gallicchio/earth-nmr-pcb/design_reviews/2026-11-03_Claude-Fable-5.1/back_12.png

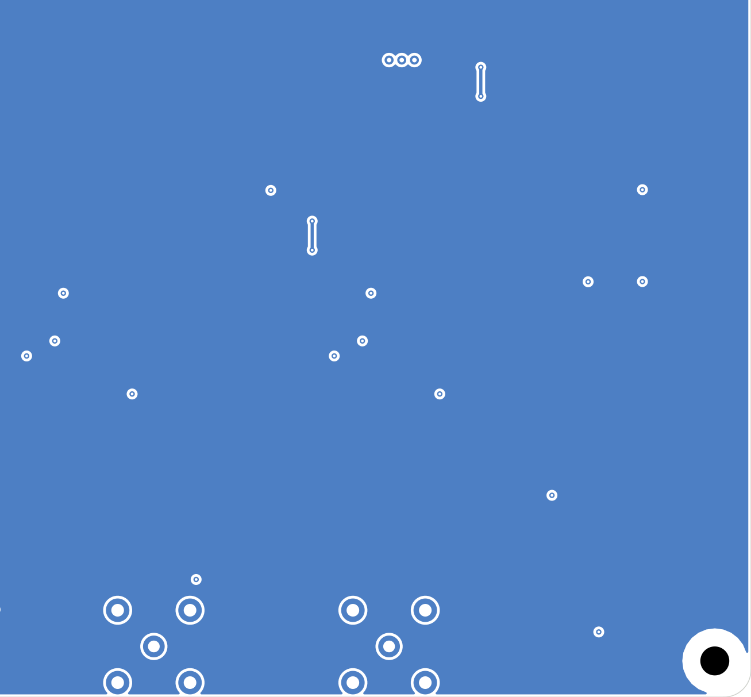
design_reviews/2026-11-03_Claude-Fable-5.1/back_12.png
