gallicchio/earth-nmr-pcb/design_reviews/2026-11-03_Claude-Fable-5.1/sch_relay_sync.png

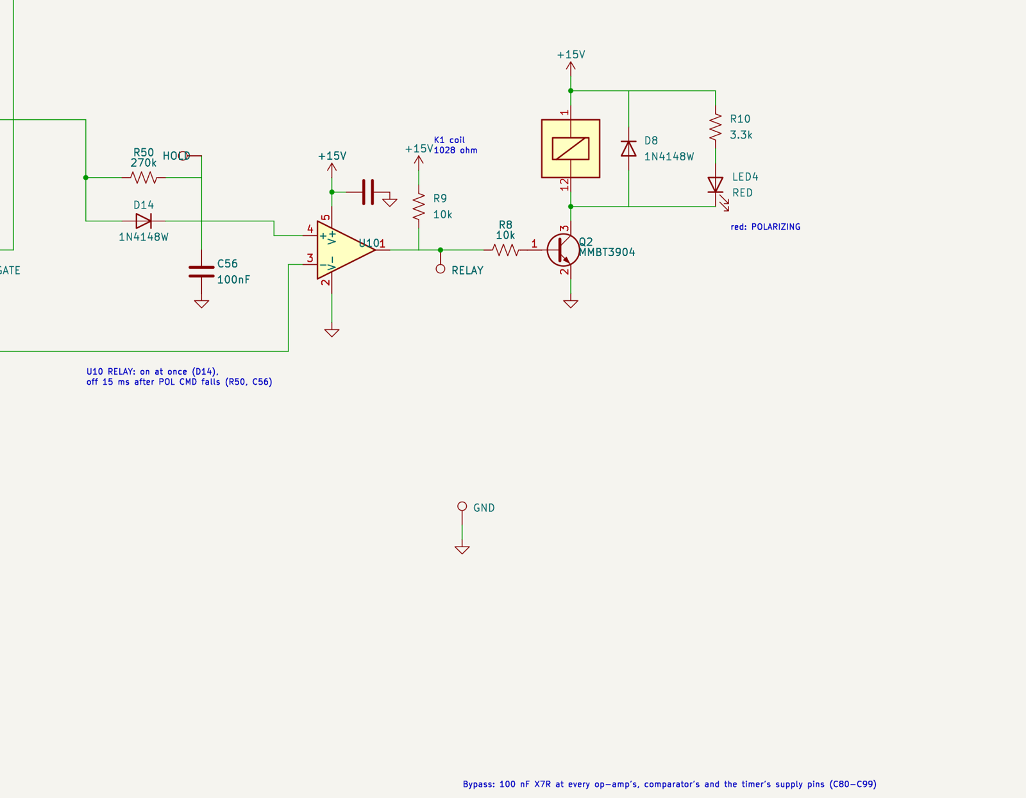
design_reviews/2026-11-03_Claude-Fable-5.1/sch_relay_sync.png
