gallicchio/earth-nmr-pcb/docs/images/earthnmr-bottom.png

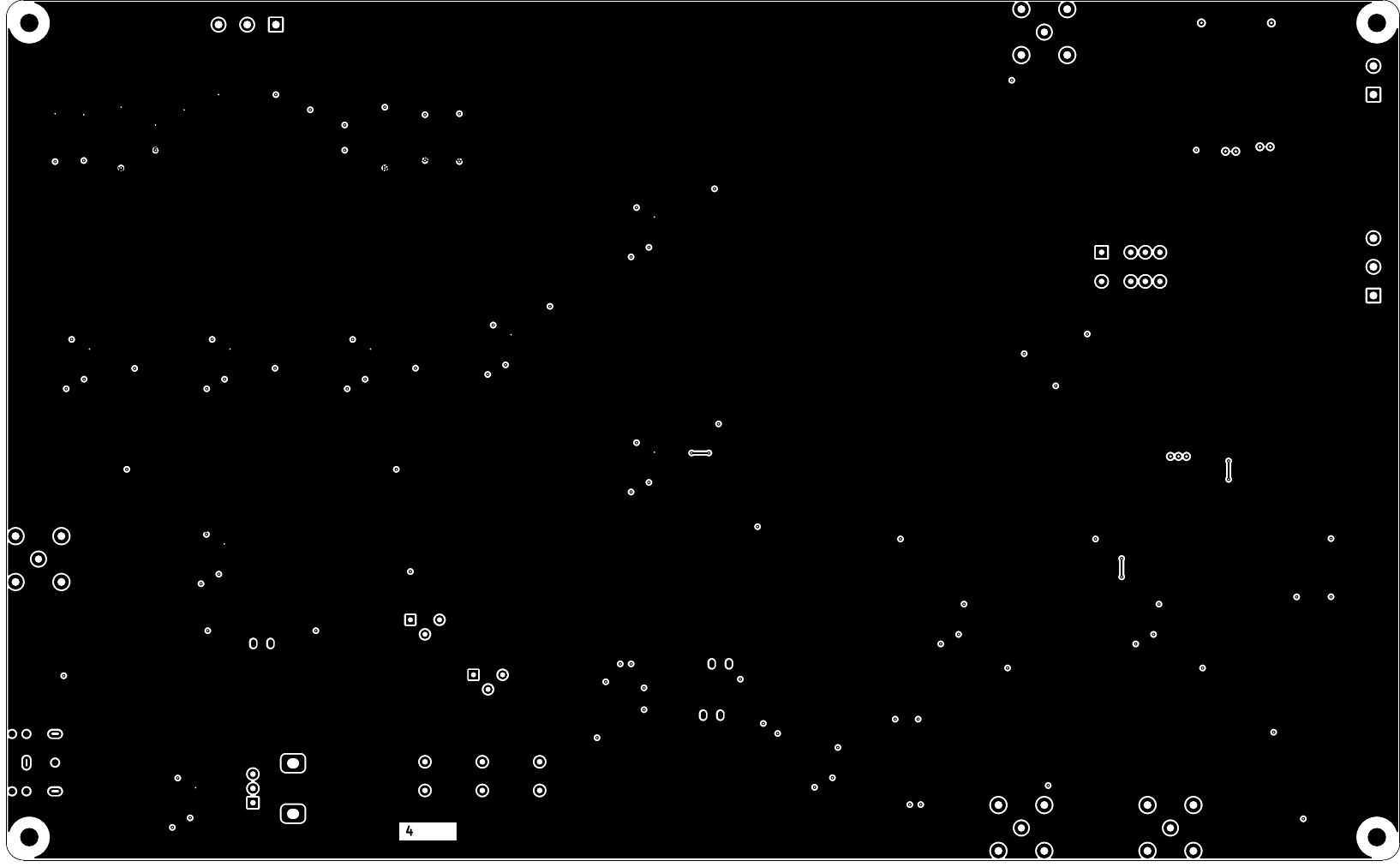
docs/images/earthnmr-bottom.png
