gallicchio/earth-nmr-pcb/docs/images/earthnmr-in1-ground.png

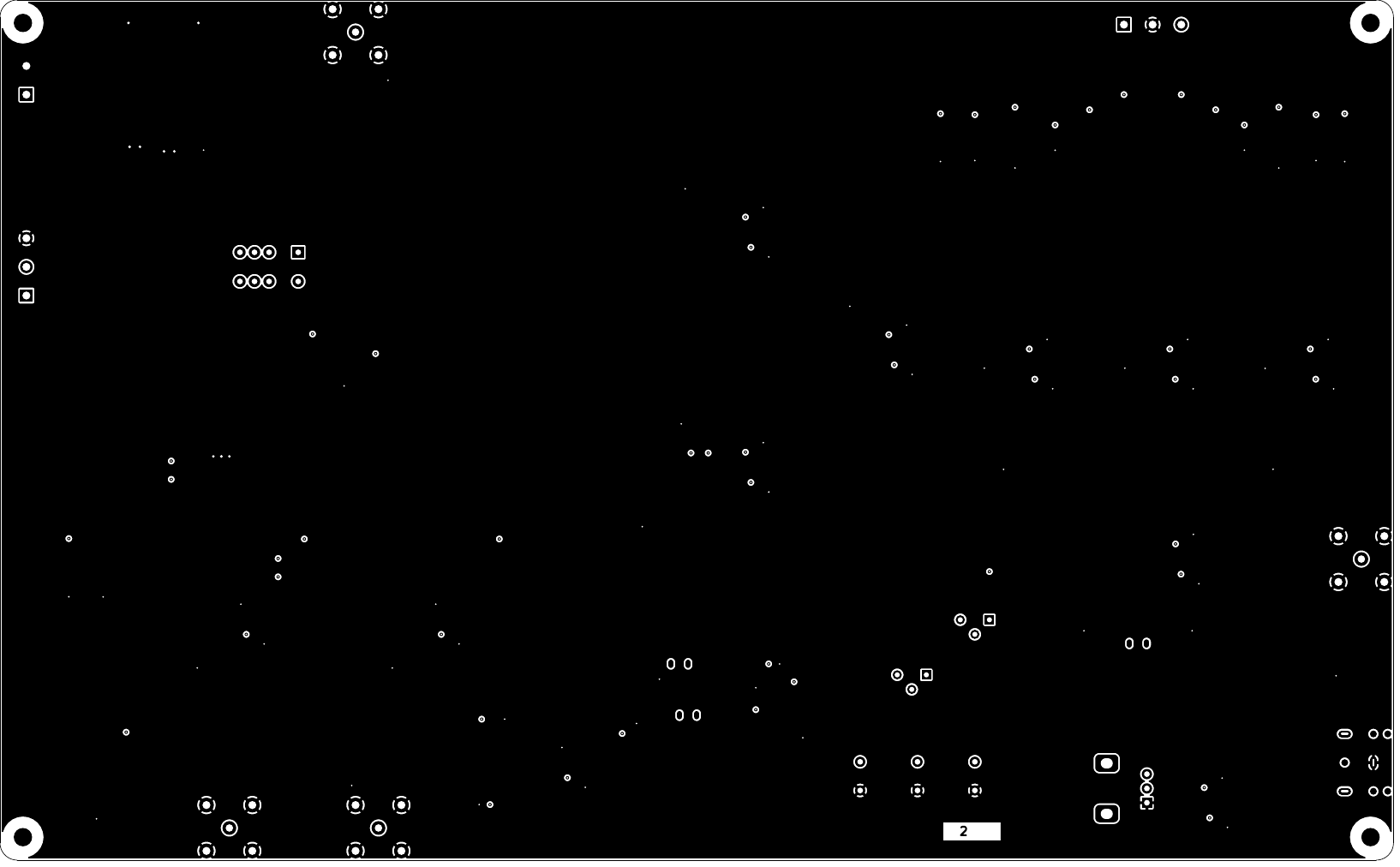
docs/images/earthnmr-in1-ground.png
