gallicchio/earth-nmr-pcb/docs/images/earthnmr-in2-plus15.png

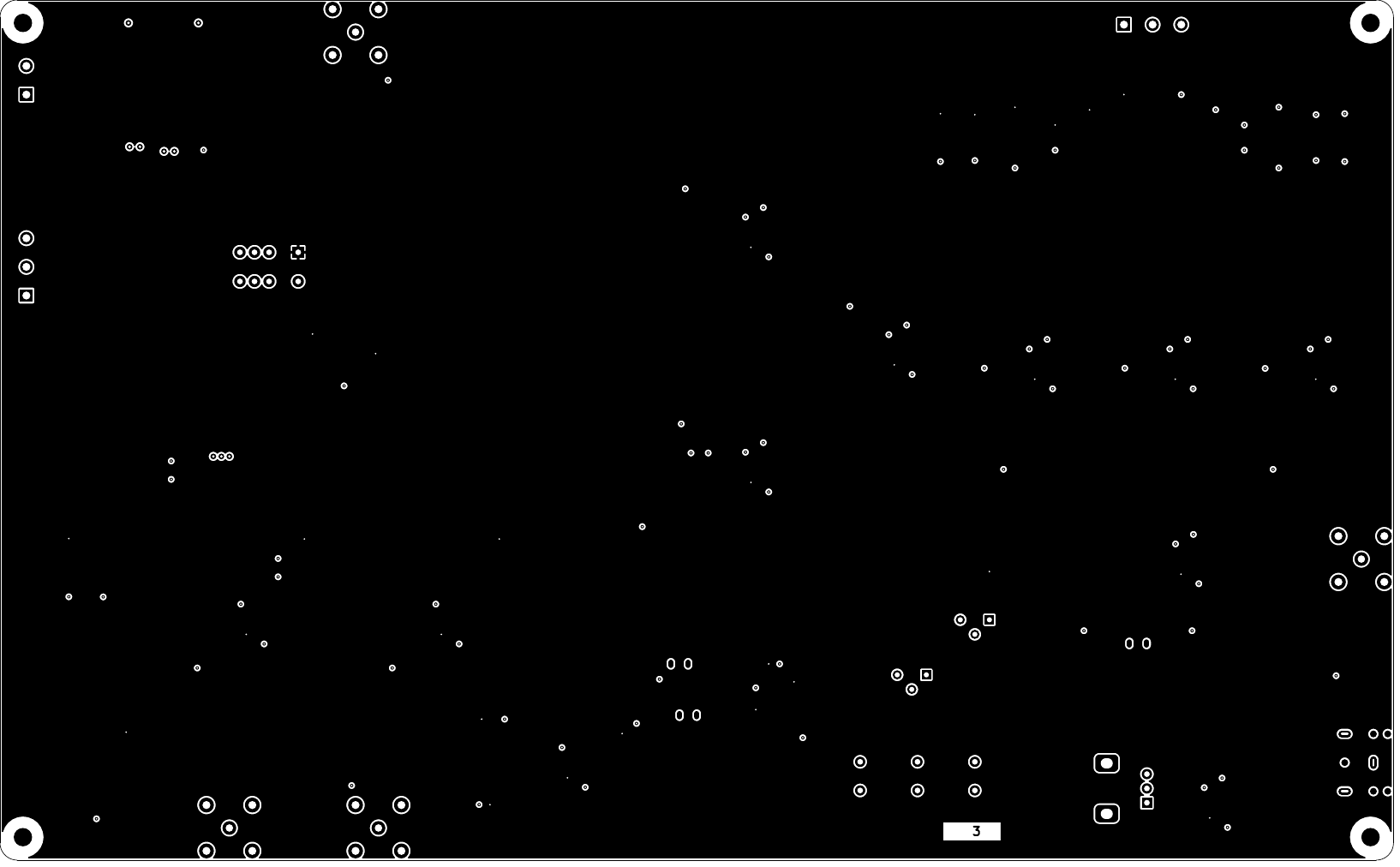
docs/images/earthnmr-in2-plus15.png
