gallicchio/earth-nmr-pcb/docs/images/earthnmr-render-bottom.png

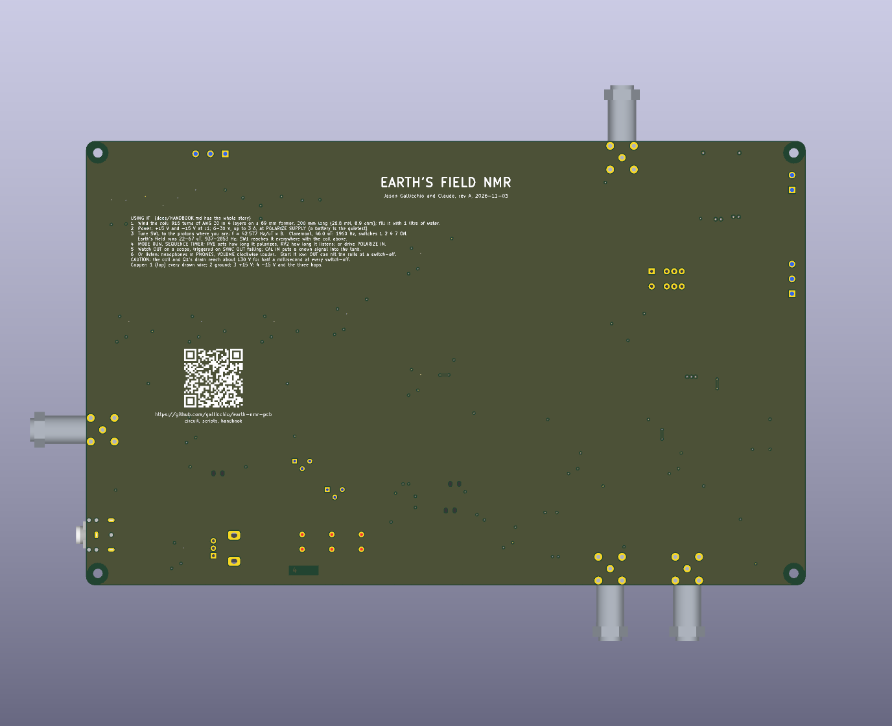
docs/images/earthnmr-render-bottom.png
