gallicchio/earth-nmr-pcb/docs/images/earthnmr-silk-bottom.png

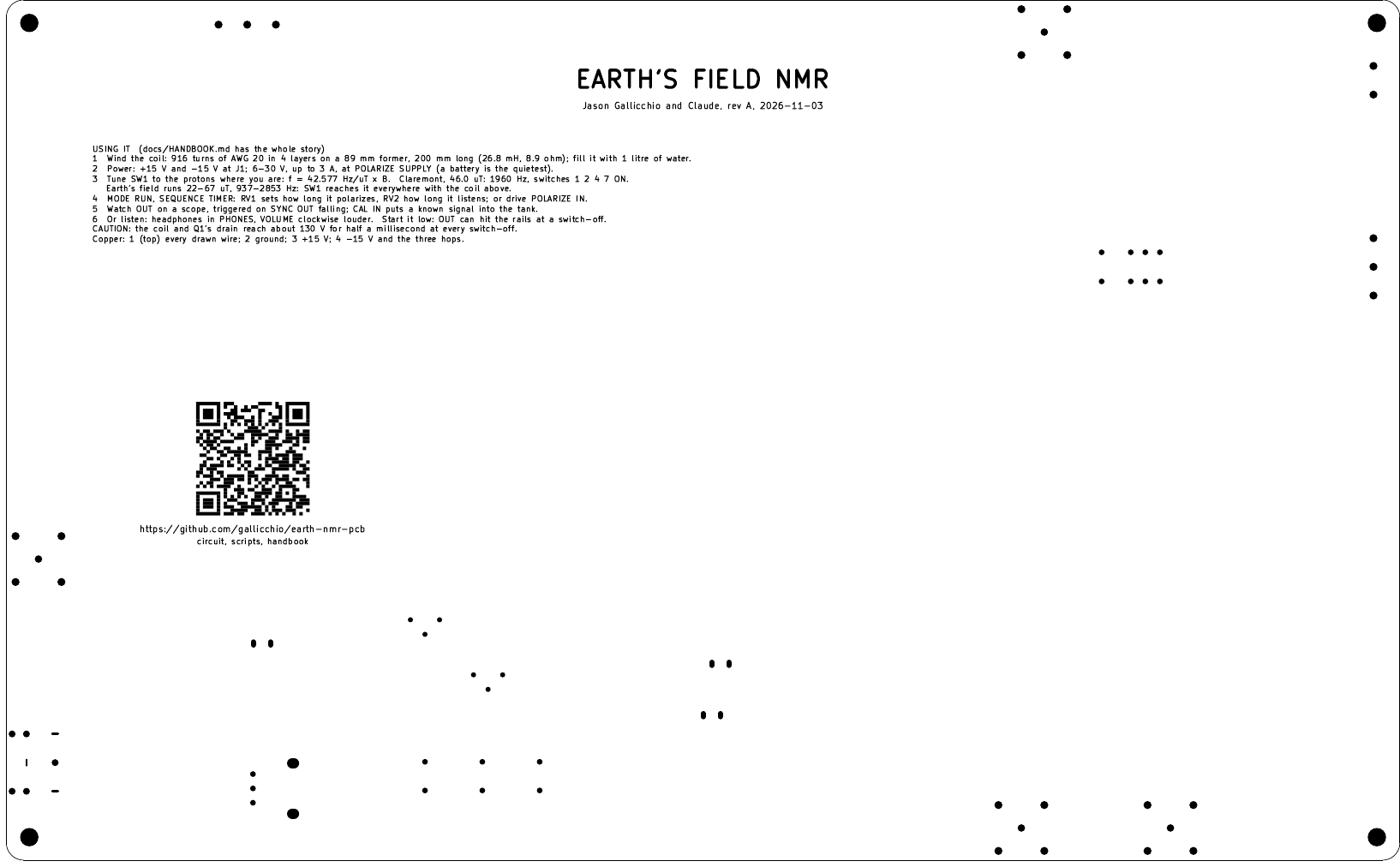
docs/images/earthnmr-silk-bottom.png
