gallicchio/earth-nmr-pcb/docs/images/earthnmr-silk-top.png

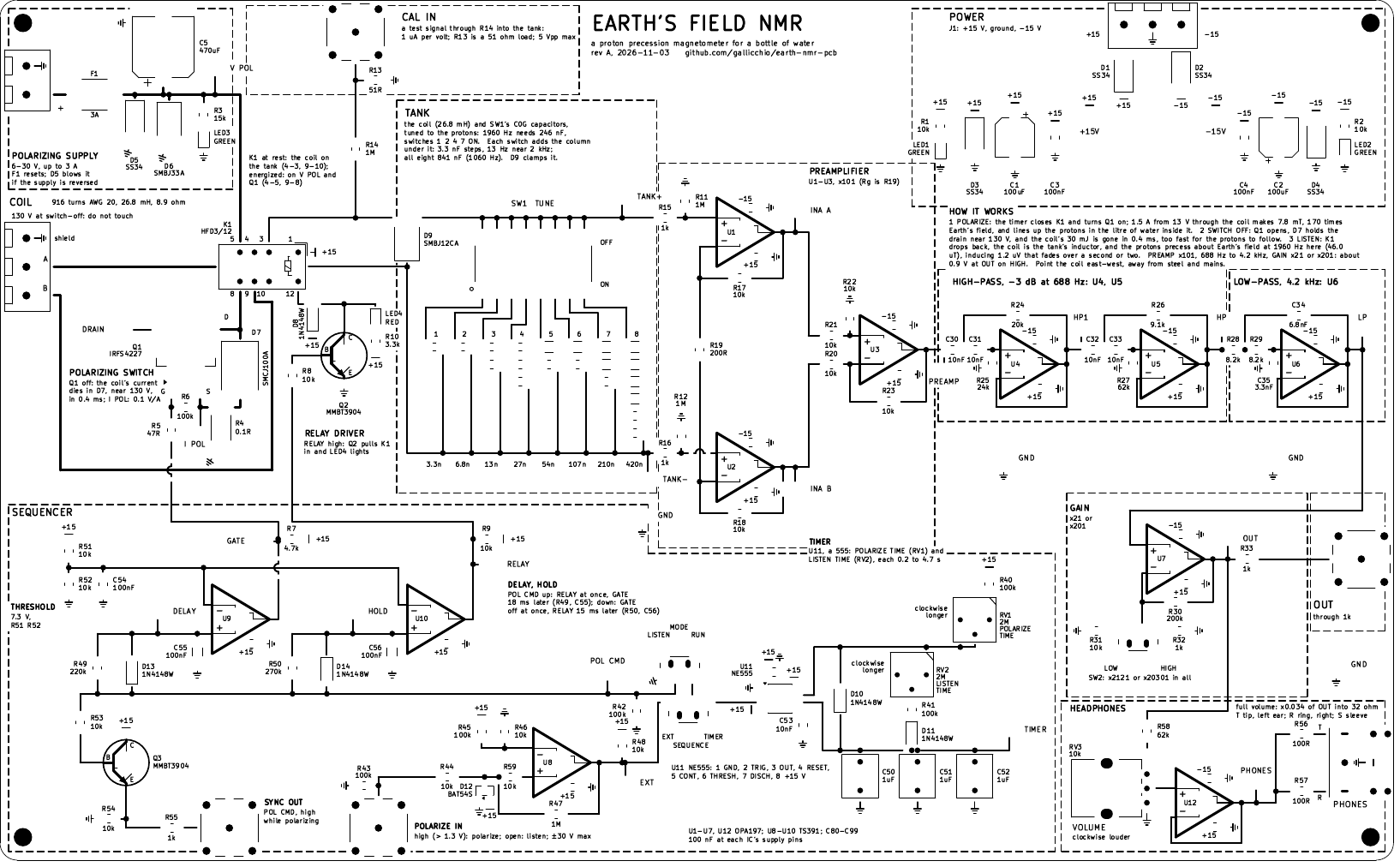
docs/images/earthnmr-silk-top.png
