gallicchio/earth-nmr-pcb/docs/images/sim_receiver.png

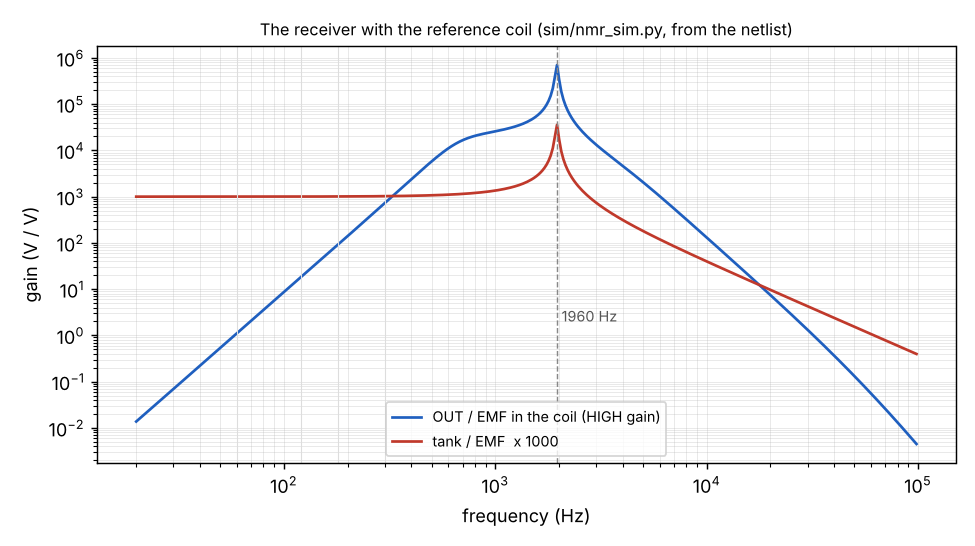
docs/images/sim_receiver.png
