gallicchio/earth-nmr-pcb/docs/images/sim_switch_off.png

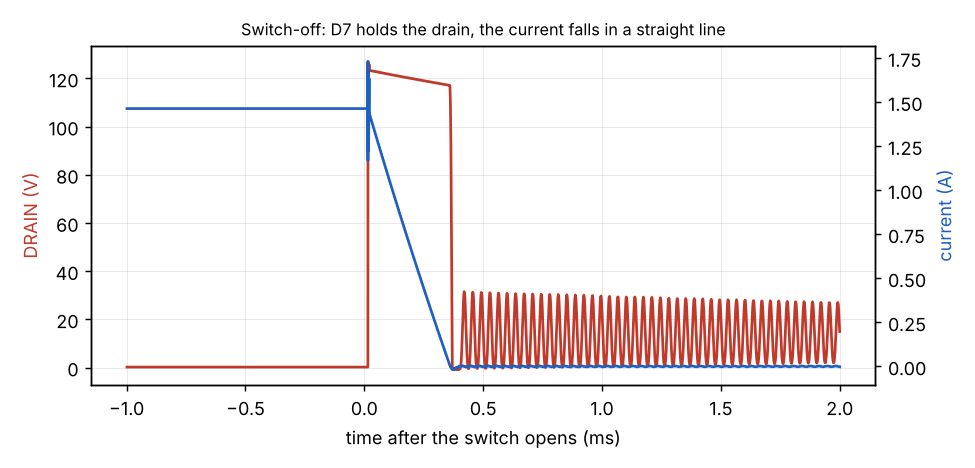
docs/images/sim_switch_off.png
