gallicchio/earth-nmr-pcb/out/earthnmr/earthnmr_bom_costed.csv

Comment | Designator | Footprint | LCSC Part # | MPN | Qty | Unit $ | Ext $ | JLC
470uF | C5 | CP_Elec_10x12.5 | C22469994 | EFVM050ADA471M10C0 | 1 | 0.1755 | 0.175 | extended
47nF | C17 | C_1206_3216Metric | C5451690 | C1206N473J050T | 1 | 0.1795 | 0.179 | extended
100uF | C1,C2 | CP_Elec_6.3x5.4 | C46550402 | JVJ25V100M6x5 | 2 | 0.0423 | 0.085 | extended
3.3nF | C10,C13,C35 | C_0805_2012Metric | C880847 | 0805N332J101CT | 3 | 0.0214 | 0.064 | extended
1uF | C50,C51,C52 | C_Film_P5.00mm_L7.2mm_W6.0mm | C333829 | MES105J2A-7-50R0 | 3 | 0.1387 | 0.416 | extended
6.8nF | C11,C16,C18,C20,C34 | C_0805_2012Metric | C326913 | CC0805JKNPO9BN682 | 5 | 0.0904 | 0.452 | extended
100nF | C19,C21,C22,C24,C25,C26,C27,C55,C56 | C_1206_3216Metric | C170182 | 1206N104J500CT | 9 | 0.1580 | 1.422 | extended
10nF | C12,C14,C15,C23,C28,C29,C30,C31,C32,C33,C53 | C_0805_2012Metric | C237168 | 0805N103J500CT | 11 | 0.0302 | 0.332 | extended
100nF | C3,C4,C54,C80,C81,C82,C83,C84,C85,C86,C87,C88,C89,C90,C91,C92,C93,C94,C95,C96,C97,C98,C99 | C_0805_2012Metric | C49678 | CC0805KRX7R9BB104 | 23 | 0.0205 | 0.472 | basic
SMBJ33A | D6 | D_SMB | C353366 | SMBJ33A | 1 | 0.0404 | 0.040 | extended
SMCJ100A | D7 | D_SMC | C42371542 | SMCJ100A | 1 | 0.0916 | 0.092 | preferred
SMBJ12CA | D9 | D_SMB | C353397 | SMBJ12CA | 1 | 0.0409 | 0.041 | extended
BAT54S | D12 | SOT-23 | C47546 | BAT54S,215 | 1 | 0.0283 | 0.028 | basic
SS34 | D1,D2,D3,D4,D5 | D_SMA | C8678 | SS34 | 5 | 0.0352 | 0.176 | basic
1N4148W | D8,D10,D11,D13,D14 | D_SOD-123 | C81598 | 1N4148W | 5 | 0.0124 | 0.062 | basic
3A | F1 | Fuse_2920_7451Metric | C22435908 | 2920L300/36GR | 1 | 0.1851 | 0.185 | extended
POWER | J1 | TerminalBlock_KF301_1x03_P5.00mm | C474882 | KF301-5.0-3P | 1 | 0.1396 | 0.140 | extended
POLARIZE SUPPLY | J2 | TerminalBlock_KF301_1x02_P5.00mm | C474881 | KF301-5.0-2P | 1 | 0.1019 | 0.102 | extended
COIL | J3 | TerminalBlock_KF301_1x03_P5.00mm | C474882 | KF301-5.0-3P | 1 | 0.1396 | 0.140 | extended
PHONES | J9 | Jack_3.5mm_CUI_SJ1-3523N_Horizontal | C20182914 | SJ1-3523N | 1 | 1.2340 | 1.234 | extended
BNC | J4,J5,J7,J8 | BNC_KYWE_RightAngle | C41416668 | BNC-KYWE-295-W4-N | 4 | 1.2929 | 5.172 | extended
HFD3/12 | K1 | Relay_DPDT_Omron_G6S-2 | C329305 | HFD3/12 | 1 | 1.3894 | 1.389 | extended
RED | LED4 | LED_0805_2012Metric | C84256 | NCD0805R1 | 1 | 0.0135 | 0.013 | basic
GREEN | LED1,LED2,LED3 | LED_0805_2012Metric | C2297 | KT-0805G | 3 | 0.0164 | 0.049 | basic
IRFS4227 | Q1 | TO-263-2 | C146578 | IRFS4227TRLPBF | 1 | 0.8286 | 0.829 | extended
MMBT3904 | Q2,Q3 | SOT-23 | C20526 | MMBT3904 | 2 | 0.0117 | 0.023 | basic
15k | R3 | R_0805_2012Metric | C17475 | 0805W8F1502T5E | 1 | 0.0059 | 0.006 | basic
0.1R | R4 | R_2512_6332Metric | C160587 | RLP25FEER100 | 1 | 0.0571 | 0.057 | extended
47R | R5 | R_0805_2012Metric | C17714 | 0805W8F470JT5E | 1 | 0.0029 | 0.003 | basic
4.7k | R7 | R_0805_2012Metric | C17673 | 0805W8F4701T5E | 1 | 0.0039 | 0.004 | basic
3.3k | R10 | R_0805_2012Metric | C26010 | 0805W8F3301T5E | 1 | 0.0043 | 0.004 | basic
51R | R13 | R_0805_2012Metric | C17738 | 0805W8F510JT5E | 1 | 0.0030 | 0.003 | basic
200R | R19 | R_0805_2012Metric | C17540 | 0805W8F2000T5E | 1 | 0.0068 | 0.007 | basic
20k | R24 | R_0805_2012Metric | C4328 | 0805W8F2002T5E | 1 | 0.0042 | 0.004 | basic
24k | R25 | R_0805_2012Metric | C17575 | 0805W8F2402T5E | 1 | 0.0044 | 0.004 | basic
9.1k | R26 | R_0805_2012Metric | C17855 | 0805W8F9101T5E | 1 | 0.0030 | 0.003 | preferred
200k | R30 | R_0805_2012Metric | C17539 | 0805W8F2003T5E | 1 | 0.0056 | 0.006 | basic
220k | R49 | R_0805_2012Metric | C17556 | 0805W8F2203T5E | 1 | 0.0030 | 0.003 | basic
270k | R50 | R_0805_2012Metric | C17589 | 0805W8F2703T5E | 1 | 0.0059 | 0.006 | preferred
10k | RV3 | Potentiometer_Alps_RK09K_Single_Vertical | C202373 | RK09K1130AAU | 1 | 0.6200 | 0.620 | extended
62k | R27,R58 | R_0805_2012Metric | C17783 | 0805W8F6202T5E | 2 | 0.0019 | 0.004 | preferred
8.2k | R28,R29 | R_0805_2012Metric | C17828 | 0805W8F8201T5E | 2 | 0.0027 | 0.005 | basic
100R | R56,R57 | R_0805_2012Metric | C17408 | 0805W8F1000T5E | 2 | 0.0042 | 0.008 | basic
2M | RV1,RV2 | Potentiometer_Bourns_3362P_Vertical | C48997907 | 3362P-1-205 | 2 | 0.2394 | 0.479 | extended
1M | R11,R12,R14,R47 | R_0805_2012Metric | C17514 | 0805W8F1004T5E | 4 | 0.0044 | 0.018 | basic
1k | R15,R16,R32,R33,R55 | R_0805_2012Metric | C17513 | 0805W8F1001T5E | 5 | 0.0035 | 0.018 | basic
100k | R6,R40,R41,R42,R43,R45 | R_0805_2012Metric | C149504 | 0805W8F1003T5E | 6 | 0.0060 | 0.036 | basic
10k | R1,R2,R8,R9,R17,R18,R20,R21,R22,R23,R31,R44,R46,R48,R51,R52,R53,R54,R59 | R_0805_2012Metric | C17414 | 0805W8F1002T5E | 19 | 0.0034 | 0.065 | basic
TUNE | SW1 | SW_DIP_SPSTx08_Slide_KingTek_DSIC08LSGET_W8.61mm_P2.54mm | C3293158 | DSIC08LSGET | 1 | 0.4889 | 0.489 | extended
GAIN | SW2 | SW_SPDT_Shouhan_MSK12C02 | C431540 | MSK12C02 | 1 | 0.0544 | 0.054 | extended
SEQUENCE | SW3 | SW_SPDT_Shouhan_MSK12C02 | C431540 | MSK12C02 | 1 | 0.0544 | 0.054 | extended
MODE | SW4 | SW_SPDT_Shouhan_MSK12C02 | C431540 | MSK12C02 | 1 | 0.0544 | 0.054 | extended
V POL | TP1 | TestPoint_Loop_RH-5019 | C5199800 | RH-5019 | 1 | 0.0966 | 0.097 | extended
DRAIN | TP2 | TestPoint_Loop_RH-5019 | C5199800 | RH-5019 | 1 | 0.0966 | 0.097 | extended
I POL | TP3 | TestPoint_Loop_RH-5019 | C5199800 | RH-5019 | 1 | 0.0966 | 0.097 | extended
GATE | TP4 | TestPoint_Loop_RH-5019 | C5199800 | RH-5019 | 1 | 0.0966 | 0.097 | extended
TANK+ | TP5 | TestPoint_Loop_RH-5019 | C5199800 | RH-5019 | 1 | 0.0966 | 0.097 | extended
TANK- | TP6 | TestPoint_Loop_RH-5019 | C5199800 | RH-5019 | 1 | 0.0966 | 0.097 | extended
INA A | TP7 | TestPoint_Loop_RH-5019 | C5199800 | RH-5019 | 1 | 0.0966 | 0.097 | extended
INA B | TP8 | TestPoint_Loop_RH-5019 | C5199800 | RH-5019 | 1 | 0.0966 | 0.097 | extended
PREAMP | TP9 | TestPoint_Loop_RH-5019 | C5199800 | RH-5019 | 1 | 0.0966 | 0.097 | extended
HP1 | TP10 | TestPoint_Loop_RH-5019 | C5199800 | RH-5019 | 1 | 0.0966 | 0.097 | extended
HP | TP11 | TestPoint_Loop_RH-5019 | C5199800 | RH-5019 | 1 | 0.0966 | 0.097 | extended
LP | TP12 | TestPoint_Loop_RH-5019 | C5199800 | RH-5019 | 1 | 0.0966 | 0.097 | extended
OUT | TP13 | TestPoint_Loop_RH-5019 | C5199800 | RH-5019 | 1 | 0.0966 | 0.097 | extended
POL CMD | TP14 | TestPoint_Loop_RH-5019 | C5199800 | RH-5019 | 1 | 0.0966 | 0.097 | extended
DELAY | TP15 | TestPoint_Loop_RH-5019 | C5199800 | RH-5019 | 1 | 0.0966 | 0.097 | extended
HOLD | TP16 | TestPoint_Loop_RH-5019 | C5199800 | RH-5019 | 1 | 0.0966 | 0.097 | extended
RELAY | TP17 | TestPoint_Loop_RH-5019 | C5199800 | RH-5019 | 1 | 0.0966 | 0.097 | extended
TIMER | TP18 | TestPoint_Loop_RH-5019 | C5199800 | RH-5019 | 1 | 0.0966 | 0.097 | extended
EXT | TP19 | TestPoint_Loop_RH-5019 | C5199800 | RH-5019 | 1 | 0.0966 | 0.097 | extended
+15V | TP20 | TestPoint_Loop_RH-5019 | C5199800 | RH-5019 | 1 | 0.0966 | 0.097 | extended
-15V | TP21 | TestPoint_Loop_RH-5019 | C5199800 | RH-5019 | 1 | 0.0966 | 0.097 | extended
PHONES | TP22 | TestPoint_Loop_RH-5019 | C5199800 | RH-5019 | 1 | 0.0966 | 0.097 | extended
GND | TP100,TP101,TP102,TP103 | TestPoint_Loop_RH-5019 | C5199800 | RH-5019 | 4 | 0.0966 | 0.386 | extended
NE555 | U11 | SOIC-8_3.9x4.9mm_P1.27mm | C7593 | NE555DR | 1 | 0.1083 | 0.108 | preferred
TS391 | U8,U9,U10 | SOT-23-5 | C71896 | TS391ILT | 3 | 0.1382 | 0.415 | extended
OPA197 | U1,U2,U3,U4,U5,U6,U7,U12 | SOT-23-5 | C221351 | OPA197IDBVR | 8 | 0.7005 | 5.604 | extended
