gallicchio/earth-nmr-pcb/docs/MANUFACTURING.md

# Manufacturing

*Generated by `scripts/gen_docs.py` from the costed BOM, the board file and the parts table: edit those, not this.*

One board, four layers, 243 x 150 mm, every part on the top side: ground on
the second layer, +15 V on the third, -15 V on the back with the three hops.  It passes ERC,
DRC at every severity with schematic parity, the 393 circuit assertions on the netlist,
the simulation's agreement with the design arithmetic and the fab-package checks, and
`./make.py` rebuilds and rechecks everything from scratch in about a minute and a half.

## What to upload

| file | where it goes |
|---|---|
| `out/earthnmr/earthnmr-gerbers.zip` | the *Add gerber file* box |
| `out/earthnmr/earthnmr_bom_jlcpcb_upload.csv` | the BOM box (JLCPCB's column layout) |
| **`out/earthnmr/earthnmr_cpl_jlcpcb_upload.csv`** | the CPL / pick-and-place box, at JLCPCB |
| `out/earthnmr/earthnmr_cpl_kicad_native.csv` | the CPL box at any other fab |
| `out/earthnmr/earthnmr-assembly-notes.txt` | paste into the assembly remark |

## The order form, field by field

The same list is in `out/earthnmr/earthnmr-fabrication-notes.txt` to keep open while ordering.

| field | pick | why |
|---|---|---|
| **PCB** | | |
| Base Material | FR-4 | the default |
| Layers | 4 | what the gerber set contains |
| Dimensions | 243 x 150 mm | read from the board outline |
| PCB Qty | 5 | the minimum |
| Product Type | Industrial/Consumer electronics | the default |
| **PCB Specifications** | | |
| Different Design | 1 | one board in the outline |
| Delivery Format | Single PCB | no panel |
| PCB Thickness | 1.6 mm | the BNC posts and the terminal blocks expect it |
| PCB Color | Green | any; the white silkscreen is the schematic and reads best on green or black |
| Silkscreen | White | the default for green |
| Material Type | FR4-Standard TG 135-140 | the default |
| Impedance Control | No | nothing on this board is fast |
| Layer Sequence | F.Cu, In1.Cu, In2.Cu, B.Cu as named | the gerbers name each layer |
| Stackup | JLC04161H-7628 | the stack-up the board file declares (1 oz outer, 0.5 oz inner) |
| Surface Finish | LeadFree HASL | students handle this board: lead-free.  ENIG is fine too |
| **High-spec Options** | | |
| Outer Copper Weight | 1 oz | the default; the polarizing current's 2 mm tracks carry 3 A with 1 oz |
| Inner Copper Weight | 0.5 oz | the default |
| Via Covering | Tented | or Plugged if the form upgrades it |
| Min via hole size/diameter | 0.3 mm / (0.4 / 0.45 mm) | the smallest via on the board is 0.30 mm drill, 0.60 mm pad |
| Board Outline Tolerance | +/-0.2 mm (Regular) | nothing mates with the edge |
| Confirm Production file | No | the gerbers are checked here |
| Mark on PCB | Remove Mark | the whole front is a drawing; nowhere for an order number |
| Electrical Test | Flying Probe Fully Test | the default |
| **PCB Assembly** | | |
| PCBA Type | Standard | four layers, a D2PAK and a relay; Economic if the form allows it for this board |
| Assembly Side | Top | every part is on the front |
| PCBA Qty | 2, or as many as the class needs | the per-order fees are the same for 2 or 20 |
| Edge Rails/Fiducials | Added by JLCPCB | the board carries three fiducials |
| Confirm Parts Placement | Yes | look at the preview against PLACEMENT_CHECKS.txt before paying |
| Parts Selection | By JLCPCB | every BOM line has an LCSC code |
| Through-hole parts | keep them: C50, C51, C52, J1, J2, J3, J4, J5, J7, J8, J9, K1, RV1, RV2, RV3 | the form lists them separately; the BNCs, terminals, relay, trimmers and film capacitors are meant to be fitted |
| Bake Components | No | nothing moisture-sensitive |

## Cost

The board has **378 SMT joints** and **54 through-hole joints** on 78 BOM lines;
25 distinct order codes are JLCPCB *Extended* parts, each with a one-off
$3.00 feeder fee.  Parts alone are **$23.97 per board**, of which the
four BNC jacks are $5.17, the relay $1.39 and the 26 test loops $2.51.

The bare-board and assembly lines below are estimates from JLCPCB's public price list for a
four-layer 243 x 150 mm board, not a quote: their order page is the authority.

**2 boards, fully assembled, through-hole parts included**

| line | cost |
|---|---|
| bare PCBs (5 made) | about $55.00 |
| parts ($23.97 x 2) | $47.95 |
| assembly: setup + stencil + THT setup + 25 extended codes + 756 SMT and 108 THT joints | about $115.97 |
| shipping (DHL) | about $25.00 |
| **total** | **about $243.91**  ($121.96 each) |

**5 boards, fully assembled, through-hole parts included**

| line | cost |
|---|---|
| bare PCBs (5 made) | about $55.00 |
| parts ($23.97 x 5) | $119.86 |
| assembly: setup + stencil + THT setup + 25 extended codes + 1890 SMT and 270 THT joints | about $122.75 |
| shipping (DHL) | about $25.00 |
| **total** | **about $322.62**  ($64.52 each) |

**10 boards, fully assembled, through-hole parts included**

| line | cost |
|---|---|
| bare PCBs (10 made) | about $85.00 |
| parts ($23.97 x 10) | $239.73 |
| assembly: setup + stencil + THT setup + 25 extended codes + 3780 SMT and 540 THT joints | about $134.07 |
| shipping (DHL) | about $25.00 |
| **total** | **about $483.80**  ($48.38 each) |

The coil, its former, the water bottle and the polarizing supply are not on the order; the
[handbook](HANDBOOK.md) lists them.

## Rotations JLCPCB needs

JLCPCB places from its own drawing of each part, and for some parts that drawing is turned
from KiCad's footprint.  The upload CPL has these angles applied, per LCSC code, from
`scripts/parts.py` `JLC_ROTATION`:

| parts | LCSC | turned by | datum shift | evidence |
|---|---|---|---|---|
| RV3 | C202373 | 270 deg | (+3.50, -2.50) mm | predicted: RK09K: as motor-pid's RK09K1130A70 (C351173), the same body; their pins along +x, turned 270 onto KiCad's (easyeda C202373: 0.00 mm), their origin the body's middle, 3.5 mm from the pins toward the posts |
| K1 | C329305 | 270 deg | (+2.54, -5.08) mm | predicted: HFD3 relay: their drawing turned a quarter from KiCad's G6S-2, their origin the middle of the pin field, (2.54, -5.08) (y up) from KiCad's pin 1 (check_rotations.py: rms 0.00 mm) |
| U11 | C7593 | 270 deg | none | predicted: NE555DR SOIC-8: JLCPCB's drawing lies along x, pin 1 at the lower left; check_rotations.py fits +270 (rms 0.13 mm) |
| J9 | C20182914 | 180 deg | (+0.00, +2.50) mm | predicted: SJ1-3523N: easyeda's drawing is KiCad's turned half round (its 1 sleeve, 2 tip, 3 ring = our S, T, R), its origin 2.5 mm from the sleeve's pin toward the tip's and the ring's |
| Q2, Q3 | C20526 | 180 deg | none | read: MMBT3904 SOT-23: their pad 1 at (+1.0,+0.95), KiCad's at (-0.94,-0.95); read in the op-amp board's rev A preview, 2026-10-29; check_rotations.py fits +180 here too |
| U1, U2, U3, U4, U5, U6, U7, U12 | C221351 | 180 deg | none | predicted: SOT-23-5: +180 read on 59 SOT-23-5 placements on the GPSDO board |
| J2 | C474881 | 180 deg | none | read: KF301-2P: as the 3P; read in the op-amp board's rev A preview |
| J1, J3 | C474882 | 180 deg | none | read: KF301-3P: EasyEDA draws the wire-entry arrows on +y, ours face the edge (-y); the pin row is symmetric, so +180 turns only the body; read in the op-amp board's rev A preview |
| D12 | C47546 | 180 deg | none | predicted: BAT54S SOT-23: the same drawing as the MMBT3904's (check_rotations.py: +180); the BAV99 (C2500) before it fitted +180 too |
| U8, U9, U10 | C71896 | 180 deg | none | predicted: SOT-23-5: +180 read on 59 SOT-23-5 placements on the GPSDO board |
| J4, J5, J7, J8 | C41416668 | 90 deg | none | read: BNC-KYWE-295-W4-N: Lorenz board rev A/B preview, built and working |
| Q1 | C146578 | 0 deg | (-2.56, +0.00) mm | predicted: IRFS4227 D2PAK: their leads at -x as KiCad's TO-263-2, their origin 2.56 mm from KiCad's, toward the leads (check_rotations.py: rms 0.00 mm); not motor-pid's MJB44H11 drawing, which is turned 180 |
| LED1, LED2, LED3 | C2297 | 0 deg | none | read: KT-0805G on KiCad's LED_0805: GPiBridge rev A preview, cathode at pad 1 |
| TP1, TP2, TP3, TP4, TP5, TP6, TP7, TP8, TP9, TP10, TP11, TP12, TP13, TP14, TP15, TP16, TP17, TP18, TP19, TP20, TP21, TP22, TP100, TP101, TP102, TP103 | C5199800 | 0 deg | none | predicted: RH-5019 test loop: one 4.0 x 2.2 pad |
| LED4 | C84256 | 0 deg | none | read: NCD0805R1 on KiCad's LED_0805: GPiBridge rev A preview, cathode at pad 1 |
| D1, D2, D3, D4, D5 | C8678 | 0 deg | none | predicted: SS34 SMA: cathode (pad 1) at -x in both drawings |

*read* means seen in a JLCPCB preview on a real order of that part on that footprint (on one
of the other boards); *predicted* means derived by fitting JLCPCB's own land pattern onto ours
by pin number (`scripts/check_rotations.py`).  Every part not listed goes at KiCad's angle.
`out/earthnmr/PLACEMENT_CHECKS.txt` is the list to hold against the preview.  After adding or
changing a part, run `scripts/check_rotations.py` and `scripts/check_pinouts.py` (they need the
network, so the build does not run them).  `check_outputs.py` proves the two CPL files differ in
nothing but those angles.

## Check these in the preview before you pay

| part | what to look for | should be |
|---|---|---|
| U1-U10, U12 | the SOT-23-5's pin 1 dot | at the upper right of each package, toward the triangle's point; pins 3 2 1 along the top |
| U11 | the SOIC-8's pin 1 dot | at the upper left |
| Q1 | the D2PAK's tab | up (toward the relay), the two leads down |
| Q2, Q3, D12 | the SOT-23's lone pin | up (the collector; D12's common) |
| D1-D8, D10, D11, D13, D14 | each diode's cathode bar | on the footprint's pad 1, the end the silkscreen bar marks |
| D9 | the SMBJ12CA | bidirectional: either way round |
| LED1-LED4 | each LED's cathode mark | on pad 1, the end the silkscreen marks |
| C1, C2, C5 | the electrolytics' negative (striped) side | on pad 2, away from the + mark |
| K1 | the relay's pin 1 | the square pad, at the upper right of the two rows |
| SW1 | the DIP's ON side | facing down, toward pads 1-8 (the silkscreen says ON) |
| SW2, SW3, SW4 | the slide switches' knob | SW3 and SW2's knob down, SW4's up; their two posts key them |
| RV1, RV2 | the trimmers' screw | keyed by their holes; fits one way |
| RV3 | the VOLUME knob's body | to the left of its three pins, the shaft up; keyed by its pins and posts |
| J1-J5, J7-J9 | the connectors' fronts | off the board edge: J1 and J4 the top, J2 and J3 the left, J5 and J9 the right, J7 and J8 the bottom |
| F1 | the PTC fuse | not polarised |
| TP1-TP22, TP100-TP103 | the test loops | one pad each, either way |

The parts that cannot go in wrong are the relay and the two trimmers: their hole patterns fit
one way, and `check_outputs.py` re-derives that from the board file on every build.

## The through-hole parts

15 parts are through-hole: **C50, C51, C52, J1, J2, J3, J4, J5, J7, J8, J9, K1, RV1, RV2, RV3**: the four BNC jacks, the three
terminal blocks, the relay, the two trimmers and the three film capacitors.  They are in the BOM
and the CPL and JLCPCB fits them for a per-order fee plus pennies a joint; keep them selected
when the form lists them.  Soldered by hand they are the 54 largest joints on the board.

## Parts, stock and alternates

Stock as JLCPCB's parts API reported it on 2026-11-03; the build re-reads every code's
description against the value and package here and stops if one has changed or run out.

| ref | value | LCSC | JLC | unit | stock then | notes |
|---|---|---|---|---|---|---|
| C1,C2 | 100uF | C46550402 | extended | $0.0423 | 170,980 | 100 uF 25 V aluminium electrolytic, SMD 6.3 x 5.4 mm: one on each analog rail |
| C3,C4,C54,C80,C81,C82,C83,C84,C85,C86,C87,C88,C89,C90,C91,C92,C93,C94,C95,C96,C97,C98,C99 | 100nF | C49678 | basic | $0.0205 | 28,101,363 | X7R 50 V 0805: supply bypass only |
| C5 | 470uF | C22469994 | extended | $0.1755 | 51,150 | 470 uF 50 V aluminium electrolytic, SMD 10 x 12.5 mm: the polarizing supply's reservoir at the board, which damps a hot-plugged lead's ringing |
| C10,C13,C35 | 3.3nF | C880847 | extended | $0.0214 | 2,944 | C0G 100 V 5 % 0805: the low-pass filter, the bank |
| C11,C16,C18,C20,C34 | 6.8nF | C326913 | extended | $0.0904 | 5,540 | C0G 50 V 5 % 0805: the low-pass filter, the bank |
| C12,C14,C15,C23,C28,C29,C30,C31,C32,C33,C53 | 10nF | C237168 | extended | $0.0302 | 22,946 | C0G 50 V 5 % 0805: the high-pass filters, the bank, the 555's CTRL |
| C17 | 47nF | C5451690 | extended | $0.1795 | 1,189 | C0G 50 V 5 % 1206 (Holy Stone): the bank; the 100 V C1206N473J101T (C20617849) first chosen had none left on 2026-11-02 |
| C19,C21,C22,C24,C25,C26,C27,C55,C56 | 100nF | C170182 | extended | $0.1580 | 152,475 | C0G 50 V 5 % 1206: the bank and the two delays |
| C50,C51,C52 | 1uF | C333829 | extended | $0.1387 | 41,777 | 1 uF 5 % 100 V metallized polypropylene film, leads on 5 mm: the 555's timing capacitor (three in parallel). Film, not X7R: its value does not move with the voltage the timer swings it through |
| D1,D2,D3,D4,D5 | SS34 | C8678 | basic | $0.0352 | 3,189,018 | SS34 3 A 40 V Schottky, SMA (1 = cathode): in series with each analog supply (a reversed supply does nothing), the rail clamps, and the polarizing supply's reverse-polarity crowbar (a reversed supply trips F1) |
| D6 | SMBJ33A | C353366 | extended | $0.0404 | 45,962 | SMBJ33A unidirectional TVS, 600 W, 33 V standoff, 53 V at 11 A, SMB (1 = cathode): across the polarizing supply, for the spike a hot-plugged bench lead rings to |
| D7 | SMCJ100A | C42371542 | preferred | $0.0916 | 19,026 | SMCJ100A unidirectional TVS, 1.5 kW (10/1000 us), 100 V standoff, 111-123 V breakdown, 162 V at 9.3 A, SMC (1 = cathode): from the MOSFET's drain to its source. It holds the coil's flyback at about 125 V, so the current falls to zero in a straight line in about half a millisecond: a sudden switch-off, which leaves the magnetization behind to precess |
| D8,D10,D11,D13,D14 | 1N4148W | C81598 | basic | $0.0124 | 3,848,610 | 1N4148W, SOD-123 (1 = cathode): the timer's steering diodes, the delays' bypass diodes, the relay coil's freewheel diode |
| D9 | SMBJ12CA | C353397 | extended | $0.0409 | 209,291 | SMBJ12CA bidirectional TVS, 600 W, 12 V standoff, 19.9 V at 30 A, 390 pF, SMB: across the tank. Idle (the tank carries microvolts) unless the relay ever lets go with coil current still flowing: then it takes the coil's energy instead of the capacitors and the preamplifier |
| D12 | BAT54S | C47546 | basic | $0.0283 | 213,847 | BAT54S two Schottky diodes in series, SOT-23 (1 = A1, 2 = K2, 3 = K1/A2, the BAV99's pinning): clamps POLARIZE IN's node to about -0.35 V and +15.3 V, inside the TS391's -0.3 V input limit once R59 is between it and the pin (a BAV99's 0.7 V was not; review 2026-11-03) |
| F1 | 3A | C22435908 | extended | $0.1851 | 14,776 | LUTE resettable fuse 2920L300/36GR: 3 A hold, 5 A trip, 36 V, 12-48 mohm, 2920: in the polarizing supply's + lead, ahead of everything |
| J1 | POWER | C474882 | extended | $0.1396 | 23,269 | 3-way 5.0 mm screw terminal block, 17 A: POWER (+15 V, GND, -15 V) and COIL (A, B, shield) |
| J2 | POLARIZE SUPPLY | C474881 | extended | $0.1019 | 49,805 | 2-way 5.0 mm screw terminal block, 17 A: the POLARIZING SUPPLY |
| J3 | COIL | C474882 | extended | $0.1396 | 23,269 | 3-way 5.0 mm screw terminal block, 17 A: POWER (+15 V, GND, -15 V) and COIL (A, B, shield) |
| J4,J5,J7,J8 | BNC | C41416668 | extended | $1.2929 | 491 | 50 ohm BNC jack, right angle, 4 ground posts on 8x8 mm (the op-amp and PID boards' jack: JLCPCB rotation +90 read off the Lorenz board's preview) |
| J9 | PHONES | C20182914 | extended | $1.2340 | 337 | CUI (Same Sky) SJ1-3523N 3.5 mm stereo jack, through-hole, right angle, no switches. Same Sky's SJ1-352XN datasheet (09/12/2024) gives the pins: 1 sleeve, 2 tip, 3 ring; KiCad's footprint names its pads S, T, R and puts them where that drawing does (the sleeve on the centre line 3.5 mm in from the edge, tip and ring 8.5 mm in, the tip on the left seen from the plug's side), and JLCPCB's land pattern for C20182914 numbers them 1, 2, 3 in the same places (scripts/check_rotations.py) |
| K1 | HFD3/12 | C329305 | extended | $1.3894 | 4,716 | Hongfa HFD3/12 DPDT signal relay, 12 V 1028 ohm coil (9 V to pull in, 24 V max), AgNi + Au bifurcated contacts, 3 A 30 VDC, 4 ms: released, the coil is the receiver's; energized, the polarizing current's. Pins as the Omron G6S-2 |
| LED1,LED2,LED3 | GREEN | C2297 | basic | $0.0164 | 2,168,263 | green 0805 LED: each analog rail, and the polarizing supply |
| LED4 | RED | C84256 | basic | $0.0135 | 2,382,163 | red 0805 LED across the relay's coil: lit while the board polarizes |
| Q1 | IRFS4227 | C146578 | extended | $0.8286 | 6,536 | IRFS4227TRLPBF (Infineon): N-channel MOSFET, 200 V, 62 A, 26 mohm at VGS = 10 V, Qg 98 nC, D2PAK (1 = G, 2 = D on the tab, 3 = S): switches the coil's polarizing current, up to 3 A |
| Q2,Q3 | MMBT3904 | C20526 | basic | $0.0117 | 2,847,223 | MMBT3904 NPN, SOT-23 (1 B, 2 E, 3 C): the relay's coil driver and the SYNC OUT follower |
| R1,R2,R8,R9,R17,R18,R20,R21,R22,R23,R31,R44,R46,R48,R51,R52,R53,R54,R59 | 10k | C17414 | basic | $0.0034 | 51,540,835 | 0805 1% 125mW thick film |
| R3 | 15k | C17475 | basic | $0.0059 | 650,678 | 0805 1% 125mW thick film |
| R4 | 0.1R | C160587 | extended | $0.0571 | 113,594 | 0.1 ohm 1 % 2 W 50 ppm/K current-sense resistor, 2512: the polarizing current's return, so I POL reads 0.1 V per ampere (0.9 W at 3 A) |
| R5 | 47R | C17714 | basic | $0.0029 | 707,403 | 0805 1% 125mW thick film |
| R6,R40,R41,R42,R43,R45 | 100k | C149504 | basic | $0.0060 | 2,874,722 | 0805 1% 125mW thick film |
| R7 | 4.7k | C17673 | basic | $0.0039 | 4,061,480 | 0805 1% 125mW thick film |
| R10 | 3.3k | C26010 | basic | $0.0043 | 1,556,844 | 0805 1% 125mW thick film |
| R11,R12,R14,R47 | 1M | C17514 | basic | $0.0044 | 1,871,742 | 0805 1% 125mW thick film |
| R13 | 51R | C17738 | basic | $0.0030 | 672,320 | 0805 1% 125mW thick film |
| R15,R16,R32,R33,R55 | 1k | C17513 | basic | $0.0035 | 41,695,943 | 0805 1% 125mW thick film |
| R19 | 200R | C17540 | basic | $0.0068 | 920,847 | 0805 1% 125mW thick film |
| R24 | 20k | C4328 | basic | $0.0042 | 1,688,056 | 0805 1% 125mW thick film |
| R25 | 24k | C17575 | basic | $0.0044 | 309,967 | 0805 1% 125mW thick film |
| R26 | 9.1k | C17855 | preferred | $0.0030 | 288,099 | 0805 1% 125mW thick film |
| R27,R58 | 62k | C17783 | preferred | $0.0019 | 217,230 | 0805 1% 125mW thick film |
| R28,R29 | 8.2k | C17828 | basic | $0.0027 | 452,125 | 0805 1% 125mW thick film |
| R30 | 200k | C17539 | basic | $0.0056 | 501,159 | 0805 1% 125mW thick film |
| R49 | 220k | C17556 | basic | $0.0030 | 376,198 | 0805 1% 125mW thick film |
| R50 | 270k | C17589 | preferred | $0.0059 | 112,780 | 0805 1% 125mW thick film |
| R56,R57 | 100R | C17408 | basic | $0.0042 | 7,565,170 | 0805 1% 125mW thick film |
| RV1,RV2 | 2M | C48997907 | extended | $0.2394 | 8,703 | 3362P 2 M single-turn cermet trimmer, top adjust (Bourns' pattern and pinout: the wiper reaches 3 turning clockwise): POLARIZE TIME and LISTEN TIME, each a rheostat between 1 and 2 with 3 tied to the wiper, so clockwise is longer |
| RV3 | 10k | C202373 | extended | $0.6200 | 5,743 | ALPS RK09K 9 mm vertical potentiometer, 10 k linear, 20 mm flat shaft, no detent: the headphones' VOLUME. motor-pid's TARGET knob without its centre detent; pin 3 is the end the wiper reaches turning clockwise |
| SW1 | TUNE | C3293158 | extended | $0.4889 | 5,117 | KingTek DSIC08LSGET 8-way DIP switch, SMD, 2.54 mm, raised sliders: each switch adds one binary weight of C0G capacitance to the tank |
| SW2 | GAIN | C431540 | extended | $0.0544 | 186,955 | SPDT slide switch, SMD, 2 = common; the knob slides toward the pin it connects. SEQUENCE, MODE and GAIN |
| SW3 | SEQUENCE | C431540 | extended | $0.0544 | 186,955 | SPDT slide switch, SMD, 2 = common; the knob slides toward the pin it connects. SEQUENCE, MODE and GAIN |
| SW4 | MODE | C431540 | extended | $0.0544 | 186,955 | SPDT slide switch, SMD, 2 = common; the knob slides toward the pin it connects. SEQUENCE, MODE and GAIN |
| TP1 | V POL | C5199800 | extended | $0.0966 | 232,266 | SMT test loop, 3.8 x 2.0 mm wire loop on one pad (Keystone 5019 style): a scope probe's hook or a mini-grabber clips onto it |
| TP2 | DRAIN | C5199800 | extended | $0.0966 | 232,266 | SMT test loop, 3.8 x 2.0 mm wire loop on one pad (Keystone 5019 style): a scope probe's hook or a mini-grabber clips onto it |
| TP3 | I POL | C5199800 | extended | $0.0966 | 232,266 | SMT test loop, 3.8 x 2.0 mm wire loop on one pad (Keystone 5019 style): a scope probe's hook or a mini-grabber clips onto it |
| TP4 | GATE | C5199800 | extended | $0.0966 | 232,266 | SMT test loop, 3.8 x 2.0 mm wire loop on one pad (Keystone 5019 style): a scope probe's hook or a mini-grabber clips onto it |
| TP5 | TANK+ | C5199800 | extended | $0.0966 | 232,266 | SMT test loop, 3.8 x 2.0 mm wire loop on one pad (Keystone 5019 style): a scope probe's hook or a mini-grabber clips onto it |
| TP6 | TANK- | C5199800 | extended | $0.0966 | 232,266 | SMT test loop, 3.8 x 2.0 mm wire loop on one pad (Keystone 5019 style): a scope probe's hook or a mini-grabber clips onto it |
| TP7 | INA A | C5199800 | extended | $0.0966 | 232,266 | SMT test loop, 3.8 x 2.0 mm wire loop on one pad (Keystone 5019 style): a scope probe's hook or a mini-grabber clips onto it |
| TP8 | INA B | C5199800 | extended | $0.0966 | 232,266 | SMT test loop, 3.8 x 2.0 mm wire loop on one pad (Keystone 5019 style): a scope probe's hook or a mini-grabber clips onto it |
| TP9 | PREAMP | C5199800 | extended | $0.0966 | 232,266 | SMT test loop, 3.8 x 2.0 mm wire loop on one pad (Keystone 5019 style): a scope probe's hook or a mini-grabber clips onto it |
| TP10 | HP1 | C5199800 | extended | $0.0966 | 232,266 | SMT test loop, 3.8 x 2.0 mm wire loop on one pad (Keystone 5019 style): a scope probe's hook or a mini-grabber clips onto it |
| TP11 | HP | C5199800 | extended | $0.0966 | 232,266 | SMT test loop, 3.8 x 2.0 mm wire loop on one pad (Keystone 5019 style): a scope probe's hook or a mini-grabber clips onto it |
| TP12 | LP | C5199800 | extended | $0.0966 | 232,266 | SMT test loop, 3.8 x 2.0 mm wire loop on one pad (Keystone 5019 style): a scope probe's hook or a mini-grabber clips onto it |
| TP13 | OUT | C5199800 | extended | $0.0966 | 232,266 | SMT test loop, 3.8 x 2.0 mm wire loop on one pad (Keystone 5019 style): a scope probe's hook or a mini-grabber clips onto it |
| TP14 | POL CMD | C5199800 | extended | $0.0966 | 232,266 | SMT test loop, 3.8 x 2.0 mm wire loop on one pad (Keystone 5019 style): a scope probe's hook or a mini-grabber clips onto it |
| TP15 | DELAY | C5199800 | extended | $0.0966 | 232,266 | SMT test loop, 3.8 x 2.0 mm wire loop on one pad (Keystone 5019 style): a scope probe's hook or a mini-grabber clips onto it |
| TP16 | HOLD | C5199800 | extended | $0.0966 | 232,266 | SMT test loop, 3.8 x 2.0 mm wire loop on one pad (Keystone 5019 style): a scope probe's hook or a mini-grabber clips onto it |
| TP17 | RELAY | C5199800 | extended | $0.0966 | 232,266 | SMT test loop, 3.8 x 2.0 mm wire loop on one pad (Keystone 5019 style): a scope probe's hook or a mini-grabber clips onto it |
| TP18 | TIMER | C5199800 | extended | $0.0966 | 232,266 | SMT test loop, 3.8 x 2.0 mm wire loop on one pad (Keystone 5019 style): a scope probe's hook or a mini-grabber clips onto it |
| TP19 | EXT | C5199800 | extended | $0.0966 | 232,266 | SMT test loop, 3.8 x 2.0 mm wire loop on one pad (Keystone 5019 style): a scope probe's hook or a mini-grabber clips onto it |
| TP20 | +15V | C5199800 | extended | $0.0966 | 232,266 | SMT test loop, 3.8 x 2.0 mm wire loop on one pad (Keystone 5019 style): a scope probe's hook or a mini-grabber clips onto it |
| TP21 | -15V | C5199800 | extended | $0.0966 | 232,266 | SMT test loop, 3.8 x 2.0 mm wire loop on one pad (Keystone 5019 style): a scope probe's hook or a mini-grabber clips onto it |
| TP22 | PHONES | C5199800 | extended | $0.0966 | 232,266 | SMT test loop, 3.8 x 2.0 mm wire loop on one pad (Keystone 5019 style): a scope probe's hook or a mini-grabber clips onto it |
| TP100,TP101,TP102,TP103 | GND | C5199800 | extended | $0.0966 | 232,266 | SMT test loop, 3.8 x 2.0 mm wire loop on one pad (Keystone 5019 style): a scope probe's hook or a mini-grabber clips onto it |
| U1,U2,U3,U4,U5,U6,U7,U12 | OPA197 | C221351 | extended | $0.7005 | 85,291 | OPA197IDBVR (TI): 36 V CMOS op-amp, 5.5 nV/rtHz at 1 kHz, fA input current, 10 MHz, rail-to-rail in and out, SOT-23-5. All seven amplifiers, one per triangle, so the silkscreen is the schematic |
| U8,U9,U10 | TS391 | C71896 | extended | $0.1382 | 14,867 | TS391ILT (ST): single comparator, 2-36 V, open-collector output, inputs to ground, SOT-23-5 (1 OUT, 2 V-, 3 IN-, 4 IN+, 5 V+). The POLARIZE IN level detector, the gate delay and the relay hold |
| U11 | NE555 | C7593 | preferred | $0.1083 | 129,624 | NE555DR (TI) bipolar 555 timer, 4.5-16 V, SOIC-8: the INT sequencer, an astable with diode-steered charge and discharge so POLARIZE and LISTEN set independently |

### If something is out of stock

- **OPA197IDBVR** (C221351): OPA196IDBVR / C2060757 (118 in stock, 15 nV/rtHz: fine after the first stage)
- **TS391ILT** (C71896): LM397MFX/NOPB / C132076 (22k, 30 V): a different pinout, 1 IN+? -- check before substituting
- **NE555DR** (C7593): NE555DTR (XBLW) / C18723595 (191k)
- **IRFS4227TRLPBF** (C146578): IRF640NSTRLPBF / C23708 (51.9k, 200 V 150 mohm: 1.4 W at 3 A, warmer)
- **HFD3/12** (C329305): G6S-2 DC12 (Omron) / C1525289 (12.6k, 2 A: limits the coil current to 2 A)
- **BAT54S,215** (C47546): BAV99 / C2500 (silicon, 0.7 V: clamps 0.4 V past the comparator's limit)
- **DSIC08LSGET** (C3293158): DSIC08LSGET / C54953 (2315 in stock, the same part)
- **3362P-1-205** (C48997907): 3362P-1-205LF / C49190490 (18.4k, $0.33)
- **BNC-KYWE-295-W4-N** (C41416668): HL2-BNC-KYWE / C48606310 (107 in stock)
- **SJ1-3523N** (C20182914): SJ1-3533NG / C4992459 (400 in stock; the same pins, its datasheet on JLCPCB, but no JLCPCB land pattern and another footprint)
- **SJ1-3523N** (C20182914): SJ-3524-SMT-TR / C20182907 (803 in stock, surface mount, 1 sleeve 2 tip 3 ring 4 tip switch; another footprint)
- **RK09K1130AAU** (C202373): RK09K1130AP5 / C470295 (3780 in stock, a 15 mm screwdriver shaft)
- **RK09K1130AAU** (C202373): RK09K1130A70 / C351173 (6302 in stock, motor-pid's: a centre detent)

The thinnest line is the BNC-KYWE-295-W4-N: 491 in stock and 4 per board, about
122 boards' worth; next the SJ1-3523N at about 337.

## After the boards arrive

The bring-up order, the expected voltage at every loop and the experiments are in
[HANDBOOK.md](HANDBOOK.md).  In one line: with no coil and no polarizing supply, power it at
+-15 V, both green lamps light, MODE at LISTEN, and a 1 V sine at CAL IN at the tank's
frequency shows at OUT; then the coil, then RUN.
