gallicchio/earth-nmr-pcb/out/earthnmr/earthnmr-assembly-top.pdf

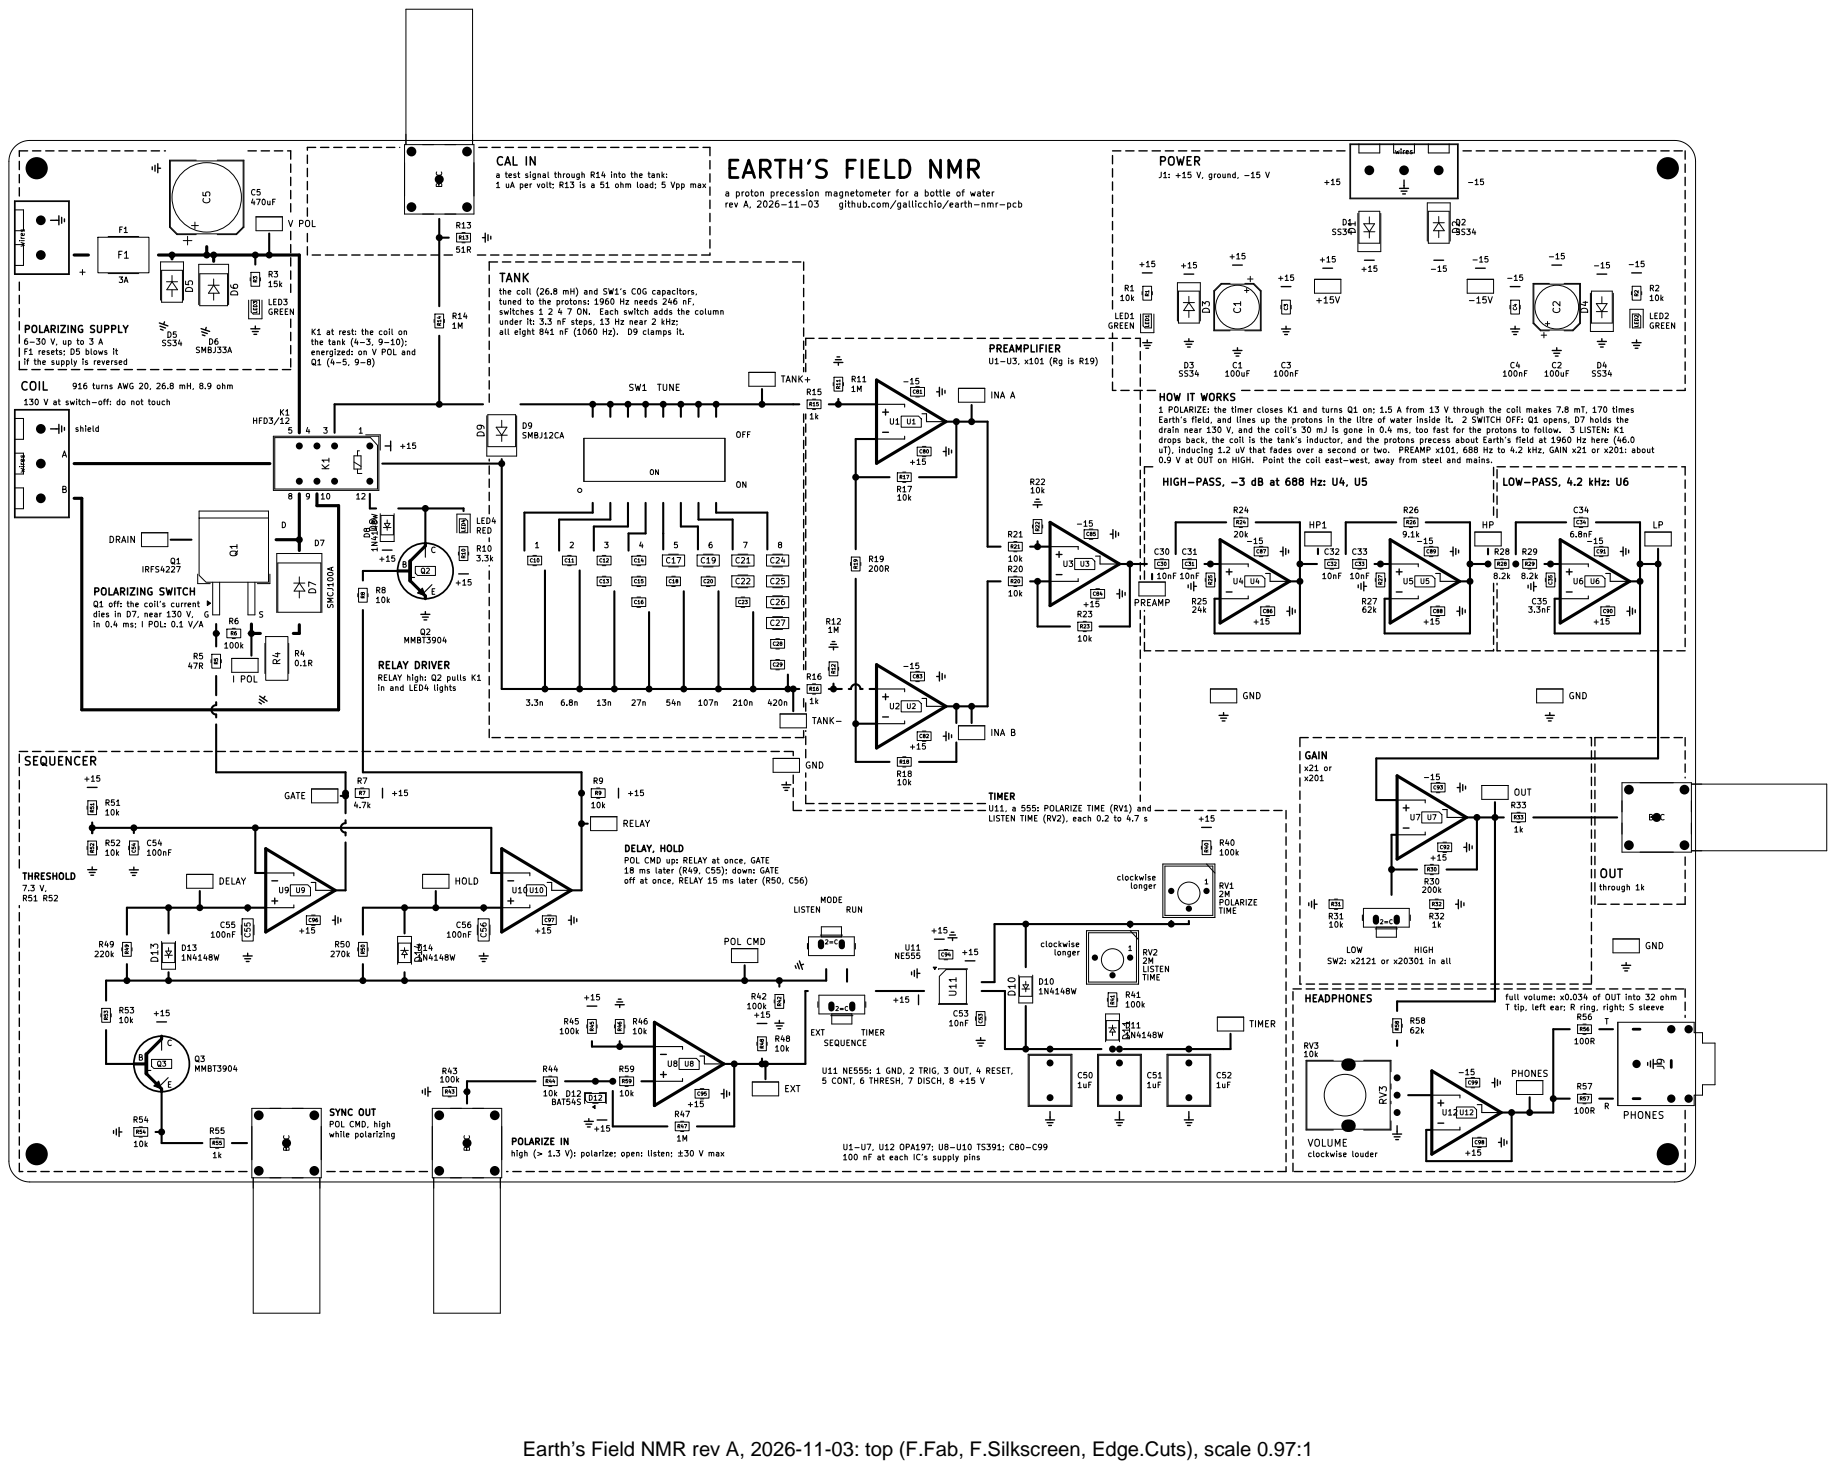
[picture p48: page 1]

CAL IN
a test signal through R14 into the tank:
1 uA per volt; R13 is a 51 ohm load; 5 Vpp max

a proton precession magnetometer for a bottle of water

TANK
the coil (26.8 mH) and SW1's C0G capacitors,
tuned to the protons: 1960 Hz needs 246 nF,
switches 1 2 4 7 ON. Each switch adds the column
under it: 3.3 nF steps, 13 Hz near 2 kHz;
all eight 841 nF (1060 Hz). D9 clamps it.

POLARIZING SUPPLY
F1 resets; D5 blows it
if the supply is reversed

K1 at rest: the coil on
the tank (4-3, 9-10);
energized: on V POL and

916 turns AWG 20, 26.8 mH, 8.9 ohm

130 V at switch-off: do not touch

HOW IT WORKS
1 POLARIZE: the timer closes K1 and turns Q1 on; 1.5 A from 13 V through the coil makes 7.8 mT, 170 times
Earth's field, and lines up the protons in the litre of water inside it. 2 SWITCH OFF: Q1 opens, D7 holds the
drain near 130 V, and the coil's 30 mJ is gone in 0.4 ms, too fast for the protons to follow. 3 LISTEN: K1
drops back, the coil is the tank's inductor, and the protons precess about Earth's field at 1960 Hz here (46.0
uT), inducing 1.2 uV that fades over a second or two. PREAMP x101, 688 Hz to 4.2 kHz, GAIN x21 or x201: about
0.9 V at OUT on HIGH. Point the coil east-west, away from steel and mains.

HIGH-PASS, -3 dB at 688 Hz: U4, U5

POLARIZING SWITCH
Q1 off: the coil's current
dies in D7, near 130 V,
in 0.4 ms; I POL: 0.1 V/A

TIMER
U11, a 555: POLARIZE TIME (RV1) and
LISTEN TIME (RV2), each 0.2 to 4.7 s

DELAY, HOLD
POL CMD up: RELAY at once, GATE
18 ms later (R49, C55); down: GATE
off at once, RELAY 15 ms later (R50, C56)

full volume: x0.034 of OUT into 32 ohm
T tip, left ear; R ring, right; S sleeve

U11 NE555: 1 GND, 2 TRIG, 3 OUT, 4 RESET,
5 CONT, 6 THRESH, 7 DISCH, 8 +15 V

POLARIZE IN
high (> 1.3 V): polarize; open: listen; ±30 V max

U1-U7, U12 OPA197; U8-U10 TS391; C80-C99
100 nF at each IC's supply pins

Earth’s Field NMR rev A, 2026-11-03: top (F.Fab, F.Silkscreen, Edge.Cuts), scale 0.97:1
