gallicchio/earth-nmr-pcb/out/earthnmr/earthnmr-schematic.pdf

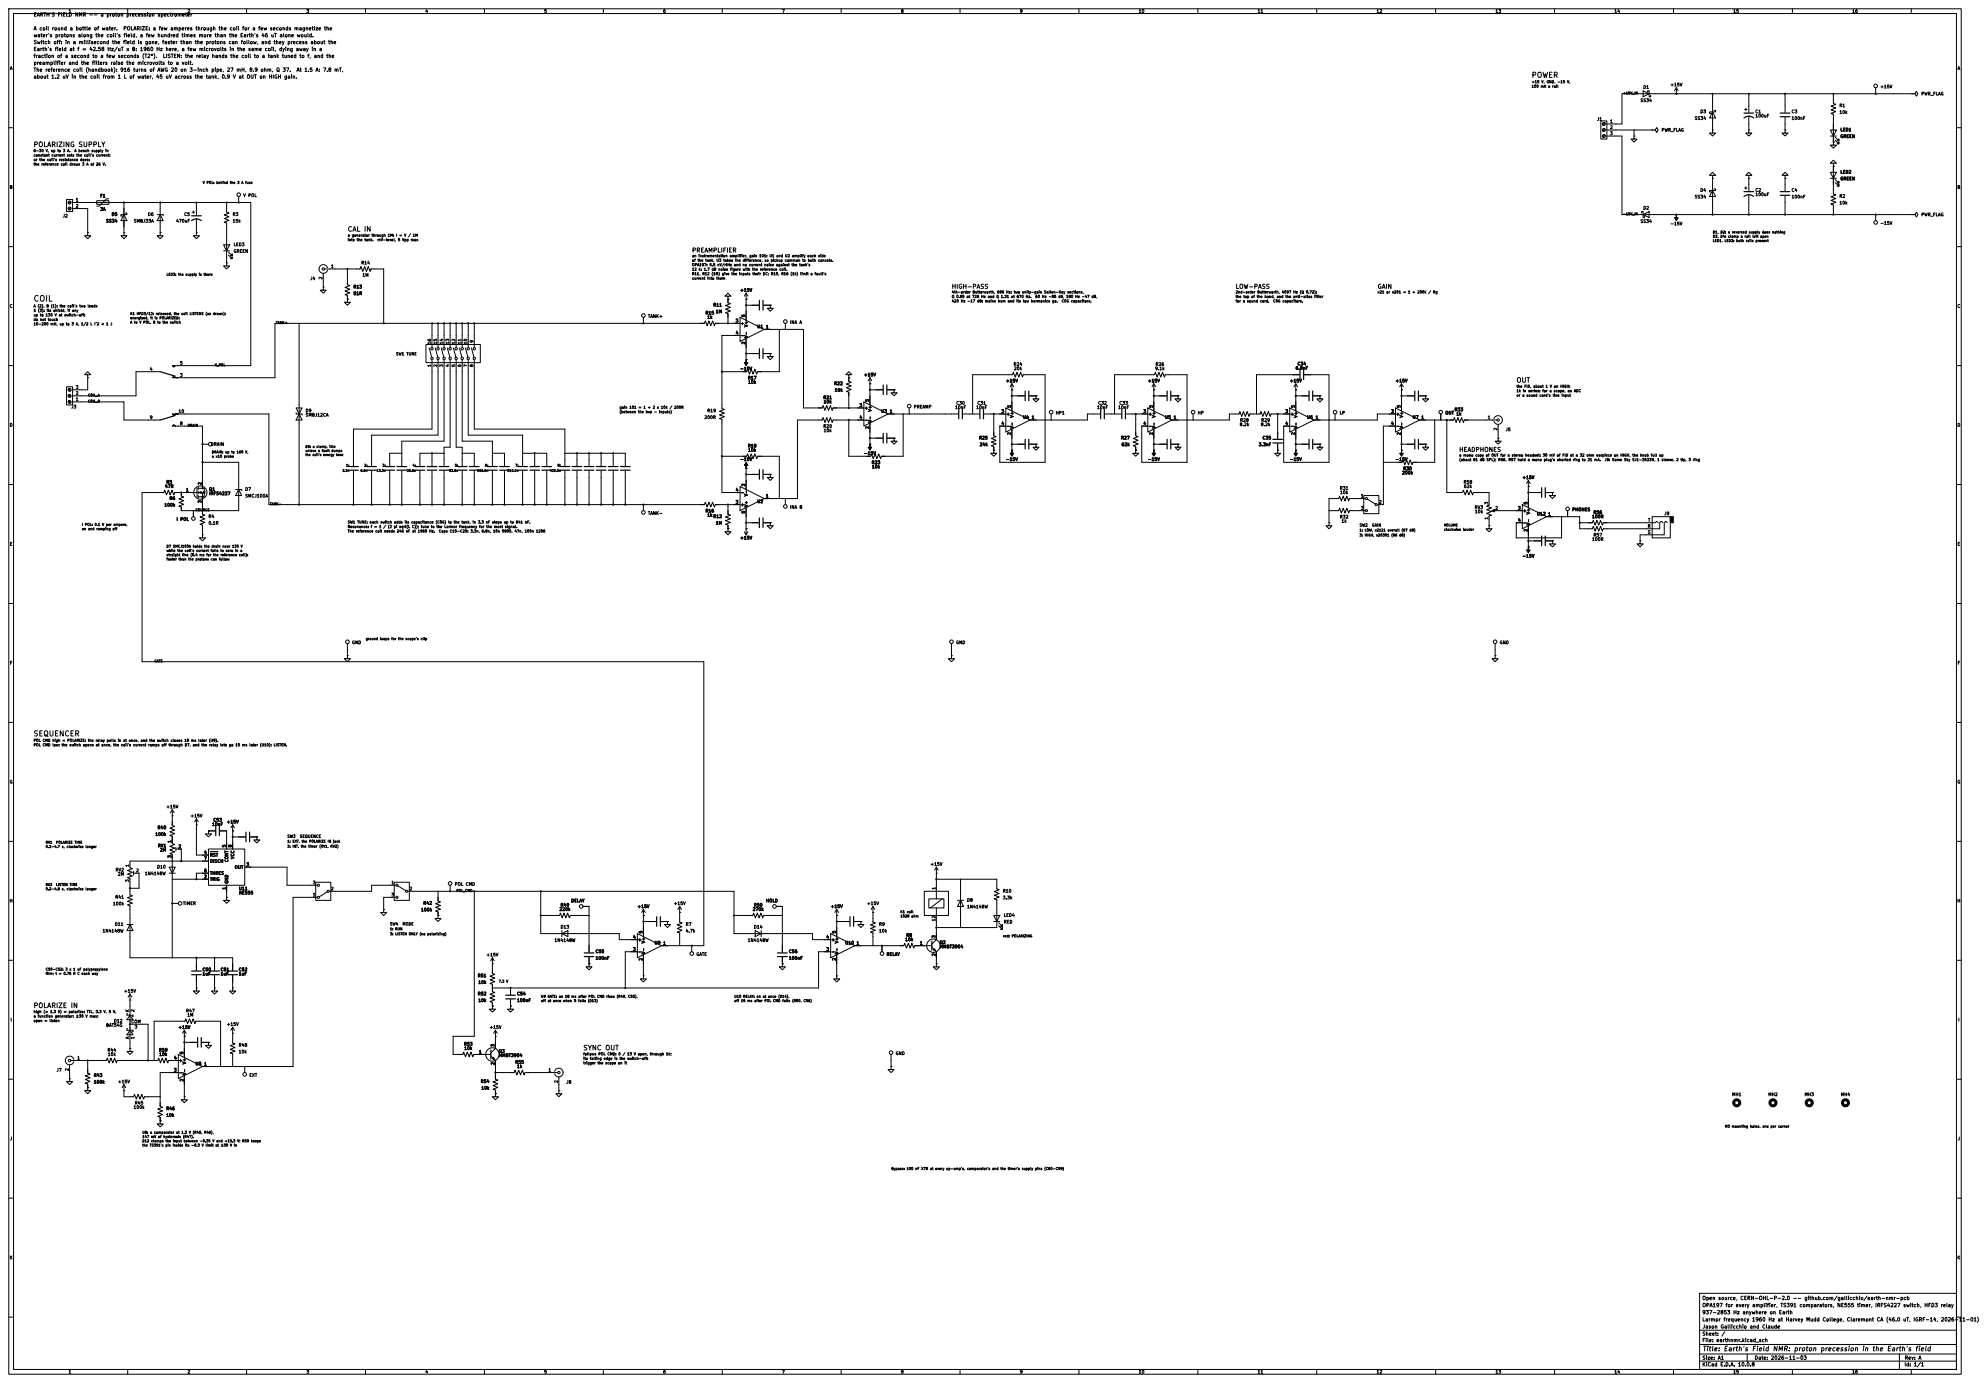
[picture p49: page 1]

EARTH'S FIELD NMR -- a proton precession spectrometer

-15V_IN A coil round a bottle of water. POLARIZE: a few amperes through the coil for a few seconds magnetize the
6-30 V, up to 3 A. A bench supply in Switch off: in a millisecond the field is gone, faster than the protons can follow, and they precess about the
fraction of a second to a few seconds (T2*). LISTEN: the relay hands the coil to a tank tuned to f, and the
preamplifier and the filters raise the microvolts to a volt.

V POL: behind the 3 A fuse

clockwise louder CAL IN

LED1, LED2: both rails present D3, D4: clamp a rail left open K1 HFD3/12: released, the coil LISTENS (as drawn);

R11, R12 (1M) give the inputs their DC; R15, R16 (1k) limit a fault's 12 k: 1.7 dB noise figure with the reference coil. of the tank, U3 takes the difference, so pickup common to both cancels.
OPA197: 5.5 nV/rtHz and no current noise against the tank's

4th-order Butterworth, 688 Hz: two unity-gain Sallen-Key sections, HIGH-PASS

up to 130 V at switch-off: S (3): its shield, if any do not touch COIL

the top of the band, and the anti-alias filter
for a sound card. C0G capacitors.

the FID, about 1 V on HIGH; the coil's energy here 1: unless a fault dumps while the coil's current falls to zero in a D7 SMCJ100A holds the drain near 130 V

1k in series: for a scope, an ADC

(between the two - inputs)

SMBJ12CA
13.3n ground loops for the scope's clip

(about 81 dB SPL); R56, R57 hold a mono plug's shorted ring to 21 mA. J9: Same Sky SJ1-3523N, 1 sleeve, 2 tip, 3 ring -15VR23

a mono copy of OUT for a stereo headset: 30 mV of FID at a 32 ohm earpiece on HIGH, the knob full up

2: The reference coil needs 246 nF at 1960 Hz. Caps C10-C29: 3.3n, 6.8n, 10n 0805, 47n, 100n 1206

I POL: 0.1 V per ampere, on and ramping off

Resonance: f = 1 / (2 pi sqrt(L C)); tune to the Larmor frequency for the most signal. SW1 TUNE: each switch adds its capacitance (C0G) to the tank, in 3.3 nF steps up to 841 nF.

SW2 GAIN
3: HIGH, x20301 (86 dB) 1: LOW, x2121 overall (67 dB)

faster than the protons can follow

POL CMD high = POLARIZE: the relay pulls in at once, and the switch closes 18 ms later (U9). POL CMD low: the switch opens at once, the coil's current ramps off through D7, and the relay lets go 15 ms later (U10): LISTEN.

RV1 POLARIZE TIME RV2 LISTEN TIME
0.2-4.7 s, clockwise longer

7.3 V C50-C52: 3 x 1 uF polypropylene 0.2-4.8 s, clockwise longer

3: LISTEN ONLY (no polarizing)

U10 RELAY: on at once (D14),

off at once when it falls (D13)

high (> 1.3 V) = polarize: TTL, 3.3 V, 5 V, POLARIZE IN

follows POL CMD: 0 / 13 V open, through 1k;
trigger the scope on it

the TS391's pin inside its -0.3 V limit at ±30 V in U8: a comparator at 1.3 V (R45, R46), 147 mV of hysteresis (R47).

D12 clamps the input between -0.35 V and +15.3 V; R59 keeps

Open source, CERN-OHL-P-2.0 -- github.com/gallicchio/earth-nmr-pcb
OPA197 for every amplifier, TS391 comparators, NE555 timer, IRFS4227 switch, HFD3 relay
937-2853 Hz anywhere on Earth
Larmor frequency 1960 Hz at Harvey Mudd College, Claremont CA (46.0 uT, IGRF-14, 2026-11-01)
Jason Gallicchio and Claude
Sheet: /
File: earthnmr.kicad_sch
Title: Earth's Field NMR: proton precession in the Earth's field

Size: A1 | Rev: A
KiCad E.D.A. 10.0.8 | Id: 1/1
