gallicchio/earth-nmr-pcb/hardware/earthnmr.kicad_pcb

## KiCad design hardware/earthnmr.kicad_pcb (2026-11-03)

Schematic: earthnmr.kicad_sch, Earth's Field NMR: proton precession in the Earth's field

Parts:
C1, C2: 100uF; CP_Elec_6.3x5.4; MPN JVJ25V100M6x5; LCSC C46550402
C3, C4, C54, C80, C81, C82, C83, C84, C85, C86, C87, C88, C89, C90, C91, C92, C93, C94, C95, C96, C97, C98, C99: 100nF; C_0805_2012Metric; MPN CC0805KRX7R9BB104; LCSC C49678
C5: 470uF; CP_Elec_10x12.5; MPN EFVM050ADA471M10C0; LCSC C22469994
C10, C13, C35: 3.3nF; C_0805_2012Metric; MPN 0805N332J101CT; LCSC C880847
C11, C16, C18, C20, C34: 6.8nF; C_0805_2012Metric; MPN CC0805JKNPO9BN682; LCSC C326913
C12, C14, C15, C23, C28, C29, C30, C31, C32, C33, C53: 10nF; C_0805_2012Metric; MPN 0805N103J500CT; LCSC C237168
C17: 47nF; C_1206_3216Metric; MPN C1206N473J050T; LCSC C5451690
C19, C21, C22, C24, C25, C26, C27, C55, C56: 100nF; C_1206_3216Metric; MPN 1206N104J500CT; LCSC C170182
C50, C51, C52: 1uF; C_Film_P5.00mm_L7.2mm_W6.0mm; MPN MES105J2A-7-50R0; LCSC C333829
D1, D2, D3, D4, D5: SS34; D_SMA; MPN SS34; LCSC C8678
D6: SMBJ33A; D_SMB; MPN SMBJ33A; LCSC C353366
D7: SMCJ100A; D_SMC; MPN SMCJ100A; LCSC C42371542
D8, D10, D11, D13, D14: 1N4148W; D_SOD-123; MPN 1N4148W; LCSC C81598
D9: SMBJ12CA; D_SMB; MPN SMBJ12CA; LCSC C353397
D12: BAT54S; SOT-23; MPN BAT54S,215; LCSC C47546
F1: 3A; Fuse_2920_7451Metric; MPN 2920L300/36GR; LCSC C22435908
J1: POWER; TerminalBlock_KF301_1x03_P5.00mm; MPN KF301-5.0-3P; LCSC C474882
J2: POLARIZE SUPPLY; TerminalBlock_KF301_1x02_P5.00mm; MPN KF301-5.0-2P; LCSC C474881
J3: COIL; TerminalBlock_KF301_1x03_P5.00mm; MPN KF301-5.0-3P; LCSC C474882
J4, J5, J7, J8: BNC; BNC_KYWE_RightAngle; MPN BNC-KYWE-295-W4-N; LCSC C41416668
J9: PHONES; Jack_3.5mm_CUI_SJ1-3523N_Horizontal; MPN SJ1-3523N; LCSC C20182914
K1: HFD3/12; Relay_DPDT_Omron_G6S-2; MPN HFD3/12; LCSC C329305
LED1, LED2, LED3: GREEN; LED_0805_2012Metric; MPN KT-0805G; LCSC C2297
LED4: RED; LED_0805_2012Metric; MPN NCD0805R1; LCSC C84256
MH1, MH2, MH3, MH4: MountingHole; MountingHole_3.2mm_M3
Q1: IRFS4227; TO-263-2; MPN IRFS4227TRLPBF; LCSC C146578
Q2, Q3: MMBT3904; SOT-23; MPN MMBT3904; LCSC C20526
R1, R2, R8, R9, R17, R18, R20, R21, R22, R23, R31, R44, R46, R48, R51, R52, R53, R54, R59: 10k; R_0805_2012Metric; MPN 0805W8F1002T5E; LCSC C17414
R3: 15k; R_0805_2012Metric; MPN 0805W8F1502T5E; LCSC C17475
R4: 0.1R; R_2512_6332Metric; MPN RLP25FEER100; LCSC C160587
R5: 47R; R_0805_2012Metric; MPN 0805W8F470JT5E; LCSC C17714
R6, R40, R41, R42, R43, R45: 100k; R_0805_2012Metric; MPN 0805W8F1003T5E; LCSC C149504
R7: 4.7k; R_0805_2012Metric; MPN 0805W8F4701T5E; LCSC C17673
R10: 3.3k; R_0805_2012Metric; MPN 0805W8F3301T5E; LCSC C26010
R11, R12, R14, R47: 1M; R_0805_2012Metric; MPN 0805W8F1004T5E; LCSC C17514
R13: 51R; R_0805_2012Metric; MPN 0805W8F510JT5E; LCSC C17738
R15, R16, R32, R33, R55: 1k; R_0805_2012Metric; MPN 0805W8F1001T5E; LCSC C17513
R19: 200R; R_0805_2012Metric; MPN 0805W8F2000T5E; LCSC C17540
R24: 20k; R_0805_2012Metric; MPN 0805W8F2002T5E; LCSC C4328
R25: 24k; R_0805_2012Metric; MPN 0805W8F2402T5E; LCSC C17575
R26: 9.1k; R_0805_2012Metric; MPN 0805W8F9101T5E; LCSC C17855
R27, R58: 62k; R_0805_2012Metric; MPN 0805W8F6202T5E; LCSC C17783
R28, R29: 8.2k; R_0805_2012Metric; MPN 0805W8F8201T5E; LCSC C17828
R30: 200k; R_0805_2012Metric; MPN 0805W8F2003T5E; LCSC C17539
R49: 220k; R_0805_2012Metric; MPN 0805W8F2203T5E; LCSC C17556
R50: 270k; R_0805_2012Metric; MPN 0805W8F2703T5E; LCSC C17589
R56, R57: 100R; R_0805_2012Metric; MPN 0805W8F1000T5E; LCSC C17408
RV1, RV2: 2M; Potentiometer_Bourns_3362P_Vertical; MPN 3362P-1-205; LCSC C48997907
RV3: 10k; Potentiometer_Alps_RK09K_Single_Vertical; MPN RK09K1130AAU; LCSC C202373
SW1: TUNE; SW_DIP_SPSTx08_Slide_KingTek_DSIC08LSGET_W8.61mm_P2.54mm; MPN DSIC08LSGET; LCSC C3293158
SW2: GAIN; SW_SPDT_Shouhan_MSK12C02; MPN MSK12C02; LCSC C431540
SW3: SEQUENCE; SW_SPDT_Shouhan_MSK12C02; MPN MSK12C02; LCSC C431540
SW4: MODE; SW_SPDT_Shouhan_MSK12C02; MPN MSK12C02; LCSC C431540
TP1: V POL; TestPoint_Loop_RH-5019; MPN RH-5019; LCSC C5199800
TP2: DRAIN; TestPoint_Loop_RH-5019; MPN RH-5019; LCSC C5199800
TP3: I POL; TestPoint_Loop_RH-5019; MPN RH-5019; LCSC C5199800
TP4: GATE; TestPoint_Loop_RH-5019; MPN RH-5019; LCSC C5199800
TP5: TANK+; TestPoint_Loop_RH-5019; MPN RH-5019; LCSC C5199800
TP6: TANK-; TestPoint_Loop_RH-5019; MPN RH-5019; LCSC C5199800
TP7: INA A; TestPoint_Loop_RH-5019; MPN RH-5019; LCSC C5199800
TP8: INA B; TestPoint_Loop_RH-5019; MPN RH-5019; LCSC C5199800
TP9: PREAMP; TestPoint_Loop_RH-5019; MPN RH-5019; LCSC C5199800
TP10: HP1; TestPoint_Loop_RH-5019; MPN RH-5019; LCSC C5199800
TP11: HP; TestPoint_Loop_RH-5019; MPN RH-5019; LCSC C5199800
TP12: LP; TestPoint_Loop_RH-5019; MPN RH-5019; LCSC C5199800
TP13: OUT; TestPoint_Loop_RH-5019; MPN RH-5019; LCSC C5199800
TP14: POL CMD; TestPoint_Loop_RH-5019; MPN RH-5019; LCSC C5199800
TP15: DELAY; TestPoint_Loop_RH-5019; MPN RH-5019; LCSC C5199800
TP16: HOLD; TestPoint_Loop_RH-5019; MPN RH-5019; LCSC C5199800
TP17: RELAY; TestPoint_Loop_RH-5019; MPN RH-5019; LCSC C5199800
TP18: TIMER; TestPoint_Loop_RH-5019; MPN RH-5019; LCSC C5199800
TP19: EXT; TestPoint_Loop_RH-5019; MPN RH-5019; LCSC C5199800
TP20: +15V; TestPoint_Loop_RH-5019; MPN RH-5019; LCSC C5199800
TP21: -15V; TestPoint_Loop_RH-5019; MPN RH-5019; LCSC C5199800
TP22: PHONES; TestPoint_Loop_RH-5019; MPN RH-5019; LCSC C5199800
TP100, TP101, TP102, TP103: GND; TestPoint_Loop_RH-5019; MPN RH-5019; LCSC C5199800
U1, U2, U3, U4, U5, U6, U7, U12: OPA197; SOT-23-5; MPN OPA197IDBVR; LCSC C221351
U8, U9, U10: TS391; SOT-23-5; MPN TS391ILT; LCSC C71896
U11: NE555; SOIC-8_3.9x4.9mm_P1.27mm; MPN NE555DR; LCSC C7593

Connections:
+15V: C1.1, C3.1, C80.1, C82.1, C84.1, C86.1, C88.1, C90.1, C92.1, C94.1, C95.1, C96.1, C97.1, C98.1, D1.1 (K), D3.1 (K), D8.1 (K), D12.2 (K), K1.1, Q3.3 (C), R1.1, R7.1, R9.1, R10.1, R40.1, R45.1, R48.1, R51.1, TP20.1, U1.5 (V+), U2.5 (V+), U3.5 (V+), U4.5 (V+), U5.5 (V+), U6.5 (V+), U7.5 (V+), U8.5 (V+), U9.5 (V+), U10.5 (V+), U11.4 (~RST), U11.8 (VCC), U12.5 (V+)
-15V: C2.2, C4.2, C81.1, C83.1, C85.1, C87.1, C89.1, C91.1, C93.1, C99.1, D2.2 (A), D4.2 (A), R2.2, TP21.1, U1.2 (V-), U2.2 (V-), U3.2 (V-), U4.2 (V-), U5.2 (V-), U6.2 (V-), U7.2 (V-), U12.2 (V-)
/+15V_IN: D1.2 (A), J1.1
/-15V_IN: D2.1 (K), J1.3
/COIL_A: J3.2, K1.4
/COIL_B: J3.1, K1.9
/DRAIN: D7.1 (K), K1.8, Q1.2 (D), TP2.1
/GATE: R5.1, R7.2, TP4.1, U9.1
/POL_CMD: D13.1 (K), D14.2 (A), R42.1, R49.1, R50.1, R53.1, SW4.2 (B), TP14.1
/SOURCE: D7.2 (A), Q1.3 (S), R4.1, R6.2, TP3.1
/TANK+: D9.2 (A2), K1.3, R14.2, R15.1, SW1.9, SW1.10, SW1.11, SW1.12, SW1.13, SW1.14, SW1.15, SW1.16, TP5.1
/TANK-: C10.2, C11.2, C12.2, C13.2, C14.2, C15.2, C16.2, C17.2, C18.2, C19.2, C20.2, C21.2, C22.2, C23.2, C24.2, C25.2, C26.2, C27.2, C28.2, C29.2, D9.1 (A1), K1.10, R16.1, TP6.1
/V_POL: C5.1, D5.1 (K), D6.1 (K), F1.2, K1.5, R3.1, TP1.1
GND: C1.2, C2.1, C3.2, C4.1, C5.2, C35.2, C50.2, C51.2, C52.2, C53.1, C54.2, C55.2, C56.2, C80.2, C81.2, C82.2, C83.2, C84.2, C85.2, C86.2, C87.2, C88.2, C89.2, C90.2, C91.2, C92.2, C93.2, C94.2, C95.2, C96.2, C97.2, C98.2, C99.2, D3.2 (A), D4.1 (K), D5.2 (A), D6.2 (A), D12.1 (A), J1.2, J2.2, J3.3, J4.2 (Ext), J5.2 (Ext), J7.2 (Ext), J8.2 (Ext), J9.S, LED1.1 (K), LED2.2 (A), LED3.1 (K), Q2.2 (E), R4.2, R11.1, R12.2, R13.2, R22.1, R25.2, R27.2, R31.1, R32.1, R42.2, R43.2, R46.2, R52.2, R54.2, RV3.1, SW4.3 (C), TP100.1, TP101.1, TP102.1, TP103.1, U8.2 (V-), U9.2 (V-), U10.2 (V-), U11.1 (GND)
unnamed: C10.1, SW1.1
unnamed: C11.1, SW1.2
unnamed: C12.1, C13.1, SW1.3
unnamed: C14.1, C15.1, C16.1, SW1.4
unnamed: C17.1, C18.1, SW1.5
unnamed: C19.1, C20.1, SW1.6
unnamed: C21.1, C22.1, C23.1, SW1.7
unnamed: C24.1, C25.1, C26.1, C27.1, C28.1, C29.1, SW1.8
unnamed: C30.1, R23.2, TP9.1, U3.1
unnamed: C30.2, C31.1, R24.1
unnamed: C32.2, C33.1, R26.1
unnamed: C34.1, R28.2, R29.1
unnamed: D8.2 (A), K1.12, LED4.1 (K), Q2.3 (C)
unnamed: D10.2 (A), RV1.2, RV1.3, RV2.1, U11.7 (DISCH)
unnamed: C50.1, C51.1, C52.1, D10.1 (K), D11.2 (A), TP18.1, U11.2 (TRIG), U11.6 (THRES)
unnamed: D11.1 (K), R41.2
unnamed: D12.3 (COM), R44.2, R47.1, R59.1
unnamed: C55.1, D13.2 (A), R49.2, TP15.1, U9.4 (+)
unnamed: C56.1, D14.1 (K), R50.2, TP16.1, U10.4 (+)
unnamed: F1.1, J2.1
unnamed: J4.1 (In), R13.1, R14.1
unnamed: J5.1 (In), R33.2
unnamed: J7.1 (In), R43.1, R44.1
unnamed: J8.1 (In), R55.2
unnamed: J9.R, R57.2
unnamed: J9.T, R56.2
unnamed: LED1.2 (A), R1.2
unnamed: LED2.1 (K), R2.1
unnamed: LED3.2 (A), R3.2
unnamed: LED4.2 (A), R10.2
unnamed: Q1.1 (G), R5.2, R6.1
unnamed: Q2.1 (B), R8.2
unnamed: Q3.1 (B), R53.2
unnamed: Q3.2 (E), R54.1, R55.1
unnamed: R8.1, R9.2, TP17.1, U10.1
unnamed: R17.2, R21.1, TP7.1, U1.1
unnamed: R18.2, R20.1, TP8.1, U2.1
unnamed: R30.2, R33.1, R58.1, TP13.1, U7.1
unnamed: R40.2, RV1.1
unnamed: R41.1, RV2.2, RV2.3
unnamed: R58.2, RV3.3
unnamed: R31.2, SW2.1 (A)
unnamed: R30.1, SW2.2 (B), U7.4 (-)
unnamed: R32.2, SW2.3 (C)
unnamed: R47.2, R48.2, SW3.1 (A), TP19.1, U8.1
unnamed: SW3.2 (B), SW4.1 (A)
unnamed: SW3.3 (C), U11.3 (OUT)
unnamed: R11.2, R15.2, U1.3 (+)
unnamed: R17.1, R19.1, U1.4 (-)
unnamed: R12.1, R16.2, U2.3 (+)
unnamed: R18.1, R19.2, U2.4 (-)
unnamed: R21.2, R22.2, U3.3 (+)
unnamed: R20.2, R23.1, U3.4 (-)
unnamed: C31.2, R25.1, U4.3 (+)
unnamed: C32.1, R24.2, TP10.1, U4.1, U4.4 (-)
unnamed: C33.2, R27.1, U5.3 (+)
unnamed: R26.2, R28.1, TP11.1, U5.1, U5.4 (-)
unnamed: C35.1, R29.2, U6.3 (+)
unnamed: C34.2, TP12.1, U6.1, U6.4 (-), U7.3 (+)
unnamed: R59.2, U8.4 (+)
unnamed: R45.2, R46.1, U8.3 (-)
unnamed: C54.1, R51.2, R52.1, U9.3 (-), U10.3 (-)
unnamed: C53.2, U11.5 (CONT)
unnamed: RV3.2, U12.3 (+)
unnamed: R56.1, R57.1, TP22.1, U12.1, U12.4 (-)

Notes on the sheet:
53.8n
gain 101 = 1 + 2 x 10k / 200R
follows POL CMD: 0 / 13 V open, through 1k;
the top of the band, and the anti-alias filter
film; t = 0.75 R C each way
3.3n
a x10 probe
off at once when it falls (D13)
the coil's energy here
A (2), B (1): the coil's two leads
on and ramping off
6.8n
3: LISTEN ONLY (no polarizing)
POL CMD low: the switch opens at once, the coil's current ramps off through D7, and the relay lets go 15 ms later (U10): LISTEN.
D12 clamps the input between -0.35 V and +15.3 V; R59 keeps
a function generator; ±30 V max;
1k in series: for a scope, an ADC
up to 130 V at switch-off:
POL CMD high = POLARIZE: the relay pulls in at once, and the switch closes 18 ms later (U9).
RV2 LISTEN TIME
13.3n
the TS391's pin inside its -0.3 V limit at ±30 V in
ground loops for the scope's clip
PREAMPLIFIER
constant current sets the coil's current;
Q 0.55 at 726 Hz and Q 1.31 at 670 Hz. 60 Hz -85 dB, 180 Hz -47 dB,
faster than the protons can follow
while the coil's current falls to zero in a
D9: a clamp, idle
Switch off: in a millisecond the field is gone, faster than the protons can follow, and they precess about the
S (3): its shield, if any
10-200 mH, up to 3 A, 1/2 L I^2 < 1 J
VOLUME
unless a fault dumps
a generator through 1M: I = V / 1M
for a sound card. C0G capacitors.
U8: a comparator at 1.3 V (R45, R46),
POLARIZE IN
1: EXT, the POLARIZE IN jack
x21 or x201 = 1 + 200k / Rg
OPA197: 5.5 nV/rtHz and no current noise against the tank's
into the tank. mV-level, 5 Vpp max
Resonance: f = 1 / (2 pi sqrt(L C)); tune to the Larmor frequency for the most signal.
RV1 POLARIZE TIME
+15 V, GND, -15 V,
0.2-4.8 s, clockwise longer
the reference coil draws 3 A at 26 V.
V POL: behind the 3 A fuse
or the coil's resistance does:
POLARIZING SUPPLY
SYNC OUT
DRAIN: up to 160 V,
do not touch
clockwise louder
D3, D4: clamp a rail left open
7.3 V
SW1 TUNE
The reference coil (handbook): 916 turns of AWG 20 on 3-inch pipe, 27 mH, 8.9 ohm, Q 37. At 1.5 A: 7.8 mT,
Bypass: 100 nF X7R at every op-amp's, comparator's and the timer's supply pins (C80-C99)
1028 ohm
POWER
SW1 TUNE: each switch adds its capacitance (C0G) to the tank, in 3.3 nF steps up to 841 nF.
CAL IN
fraction of a second to a few seconds (T2*). LISTEN: the relay hands the coil to a tank tuned to f, and the
C50-C52: 3 x 1 uF polypropylene
LED3: the supply is there
COIL
the FID, about 1 V on HIGH;
K1 HFD3/12: released, the coil LISTENS (as drawn);
1: LOW, x2121 overall (67 dB)
SW3 SEQUENCE
high (> 1.3 V) = polarize: TTL, 3.3 V, 5 V,
U10 RELAY: on at once (D14),
147 mV of hysteresis (R47).
3: HIGH, x20301 (86 dB)
K1 coil
LED1, LED2: both rails present
trigger the scope on it
D7 SMCJ100A holds the drain near 130 V
SW4 MODE
1: RUN
open = listen
its falling edge is the switch-off:
off 15 ms after POL CMD falls (R50, C56)
26.8n
A to V POL, B to the switch
(between the two - inputs)
HIGH-PASS
M3 mounting holes, one per corner
HEADPHONES
current into them
The reference coil needs 246 nF at 1960 Hz. Caps C10-C29: 3.3n, 6.8n, 10n 0805, 47n, 100n 1206
3: INT, the timer (RV1, RV2)
EARTH'S FIELD NMR -- a proton precession spectrometer
LOW-PASS
Earth's field at f = 42.58 Hz/uT x B: 1960 Hz here, a few microvolts in the same coil, dying away in a
U9 GATE: on 18 ms after POL CMD rises (R49, C55),
SW2 GAIN
SEQUENCER
red: POLARIZING
(about 81 dB SPL); R56, R57 hold a mono plug's shorted ring to 21 mA. J9: Same Sky SJ1-3523N, 1 sleeve, 2 tip, 3 ring
4th-order Butterworth, 688 Hz: two unity-gain Sallen-Key sections,
GAIN
or a sound card's line input
an instrumentation amplifier, gain 101: U1 and U2 amplify each side
I POL: 0.1 V per ampere,
energized, it is POLARIZED:
straight line (0.4 ms for the reference coil):
R11, R12 (1M) give the inputs their DC; R15, R16 (1k) limit a fault's
water's protons along the coil's field, a few hundred times more than the Earth's 46 uT alone would.
106.8n
2nd-order Butterworth, 4097 Hz (Q 0.72):
a mono copy of OUT for a stereo headset: 30 mV of FID at a 32 ohm earpiece on HIGH, the knob full up
preamplifier and the filters raise the microvolts to a volt.
D1, D2: a reversed supply does nothing
12 k: 1.7 dB noise figure with the reference coil.
210.0n
A coil round a bottle of water. POLARIZE: a few amperes through the coil for a few seconds magnetize the
6-30 V, up to 3 A. A bench supply in
420.0n
of the tank, U3 takes the difference, so pickup common to both cancels.
about 1.2 uV in the coil from 1 L of water, 45 uV across the tank, 0.9 V at OUT on HIGH gain.
100 mA a rail
OUT
0.2-4.7 s, clockwise longer
420 Hz -17 dB: mains hum and its low harmonics go. C0G capacitors.

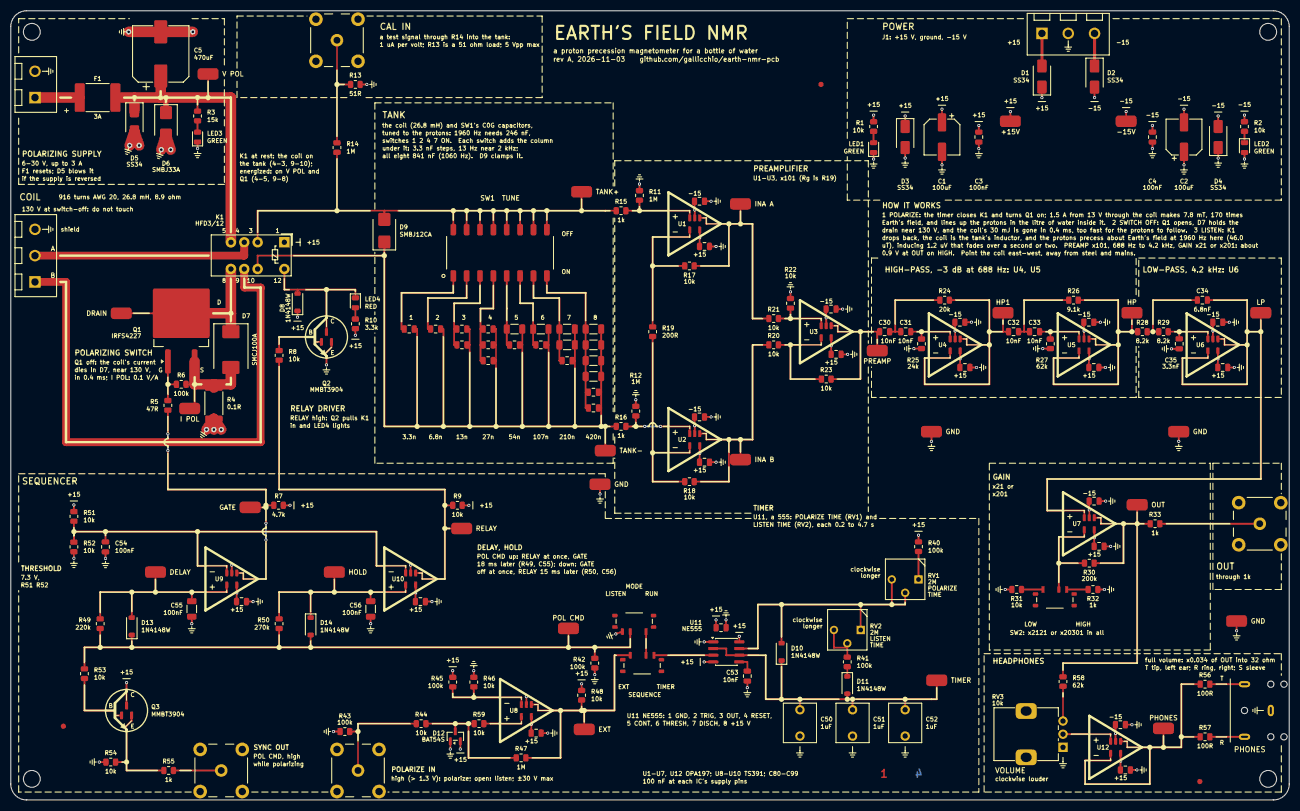
[picture p50: board earthnmr.kicad_pcb from above]

Board: 4 copper layers, 243.0 x 150.0 mm, 191 parts (0 on the bottom side), 79 nets.
