gallicchio/earth-nmr-pcb/(commit log)

2026-11-02 Scaffold: licences (CERN-OHL-P-2.0 hardware, MIT scripts), .gitignore, the shared KiCad/JLCPCB tooling from motor-pid
    The generic scripts (KiCad locator, S-expression writer and parser, schematic
    builder, JLCPCB parts API and EasyEDA land-pattern fetcher, QR encoder, PDF
    fitter) are copied from github.com/gallicchio/motor-pid; jlc_datasheet.py
    now follows LCSC's new HTML datasheet viewer to the PDF it embeds.
    Claude-Session: https://claude.ai/code/session_01Uf588FotZsxqNys61dgBLH
2026-11-02 The circuit: parts table, design arithmetic, symbols, the schematic and its netlist check
    sim/design.py holds every computed value: the Larmor frequency at Harvey
    Mudd (IGRF-14, 46.0 uT, 1960 Hz), the reference coil (916 turns AWG 20 on
    3-inch pipe: 26.8 mH, 8.9 ohm, Q 37), the FID and noise budget (45 uV across
    the tank, NF 1.7 dB with OPA197s), the binary C0G tuning bank (3.3 nF steps to
    841 nF, gap-free), the 4th-order 700 Hz high-pass and 4.1 kHz low-pass fitted
    to stocked values, the gains (x2121 / x20301), the 555's times (0.2-4.7 s each
    way), the gate delay (18 ms) and the relay hold (15 ms).
    scripts/gen_sch.py draws the whole board on one A1 sheet from it.
    scripts/check_circuit.py w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
    [earthnmr.kicad_sch]
2026-11-02 Footprints, 3D stand-ins, and the ngspice simulation from the netlist; the audio jack dropped
    sim/nmr_sim.py writes its decks from out/earthnmr.net and checks them against
    sim/design.py: the tank x35 at 1960 Hz with the reference coil (Q 36 loaded),
    0.83 V of FID at OUT on HIGH, input noise 0.49 nV/rtHz against the coil's own
    0.38, the switch-off ramp 0.39 ms with the drain clamped at 127 V, the gate
    delay 17.7 ms and the relay's hold 16.0 ms.
    The PJ-320D's documents do not say which pad is tip, ring or sleeve, so
    rev A has no audio jack: OUT and a BNC-to-3.5 mm cable feed a sound card.
    Claude-Session: https://claude.ai/code/session_0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
    [earthnmr.kicad_sch]
2026-11-02 Coil terminal: shield on top, A in the middle, B at the bottom (to suit the board's floorplan)
    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
    [earthnmr.kicad_sch]
2026-11-02 The board: layout.py and gen_pcb.py, every wire drawn on the top copper and the silkscreen; DRC clean
    The coil's two leads close a loop round the polarizing switch, so the 3 A
    path needs no hop; GATE, RELAY and U2's + input each dive under one wire.
    SW3's throws swapped (1 EXT, 3 INT) so the sequencer lays out flat.
    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
    [earthnmr.kicad_pcb, earthnmr.kicad_sch]
2026-11-02 Board words: block titles and boxes, connector, switch and relay-pin labels, the bank's column values, how it works, the back's instructions
    Every number printed comes from sim/design.json.
    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
    [earthnmr.kicad_pcb]
2026-11-02 make.py builds everything; the fab package (gerbers, drill, BOM, CPL native and for JLCPCB, prints, renders) and its checks
    The 47 nF C0G of tuning column 5 had sold out: Holy Stone's C1206N473J050T
    (C5451690, 1248 in stock) instead. kienv finds a Python that can import
    pcbnew (the PPA's KiCad is built for /usr/bin/python3).
    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
    [earthnmr-B_Cu.gbr, earthnmr-B_Mask.gbr, earthnmr-B_Paste.gbr, earthnmr-B_Silkscreen.gbr, earthnmr-Edge_Cuts.gbr, earthnmr-F_Cu.gbr, earthnmr-F_Mask.gbr, earthnmr-F_Paste.gbr]
2026-11-02 Documents: README, handbook, design notes, the generated MANUFACTURING.md and order notes, this log; a review brief
    JLCPCB's own land patterns fitted on every part (check_rotations.py, from
    motor-pid): the relay, 555, SOT-23s, D2PAK and terminal blocks needed turns or
    datum shifts, now in parts.JLC_ROTATION; every pad lands within 0.3 mm but
    D9's. check_pinouts.py: the TS391, OPA197, NE555, MMBT3904, MOSFET and diodes
    agree with JLCPCB's symbols. The MSK12C02's 3D model scaled 1/2.54 (it
    rendered 2.54 times too big). Sheet notes read their numbers from the design.
    Claude-Session: https://claude.ai/code/session_01Uf588FotZsxqNys61dgB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
    [earthnmr.kicad_pcb, earthnmr.kicad_sch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]
2026-11-02 The tilted 3D render to build/ (KiCad renders it differently each run); the log's time range
    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
2026-11-02 Headphones: a VOLUME knob, an OPA197 follower and a Same Sky SJ1-3523N jack; chat log Response 2
    OUT through R58 (62k) onto RV3 (ALPS RK09K 10k, clockwise louder), U12 follows the wiper,
    100 ohm to each of J9's tip and ring: x0.034 of OUT into 32 ohm, 30 mV of FID on HIGH
    (~81 dB SPL), simulated x0.0337 from the netlist. The jack's pinout (1 sleeve, 2 tip,
    3 ring) is Same Sky's table, matched by KiCad's footprint and JLCPCB's numbered land
    pattern at 0.00 mm (check_rotations.py takes a pad-name map now). gen_pcb.py clears a
    library footprint's BOM/placement exclusions and drops its Edge.Cuts and off-board silk.
    JLC_ROTATION for C20182914 (+180, 2.5 mm) and C202373 (+270, as motor-pid's RK0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
    [earthnmr-B_Cu.gbr, earthnmr-B_Mask.gbr, earthnmr-B_Silkscreen.gbr, earthnmr-F_Cu.gbr, earthnmr-F_Mask.gbr, earthnmr-F_Paste.gbr, earthnmr-F_Silkscreen.gbr, earthnmr-In1_Cu.gbr]
2026-11-03 Design review round 1 (the author's): POLARIZE IN clamped by a BAT54S with R59 behind it, the sheet's notes off the wires, limits at every connector; chat log Response 5
    The review (design_reviews/2026-11-03_Claude-Fable-5.1/REPORT.md) read CLAUDE_PCB.md
    in full, every block of the sheet at 250 dpi and both sides of the board at 400 dpi,
    and re-derived the physics, the sequencer's order in every case and the ratings.
    Verdict: order after named fixes, all applied here.
    - D12 BAT54S (C47546) and R59 10k: the BAV99 clamped U8's input at -0.7 V, past the
    TS391's -0.3 V absolute maximum (datasheet note 3); a bipolar generator broke it
    every half cycle. The hysteresis taps the clamped node.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
    [earthnmr-B_Cu.gbr, earthnmr-B_Mask.gbr, earthnmr-B_Paste.gbr, earthnmr-B_Silkscreen.gbr, earthnmr-Edge_Cuts.gbr, earthnmr-F_Cu.gbr, earthnmr-F_Mask.gbr, earthnmr-F_Paste.gbr]
